darkmass2156/PCS/docs/display/pingu_preview.png

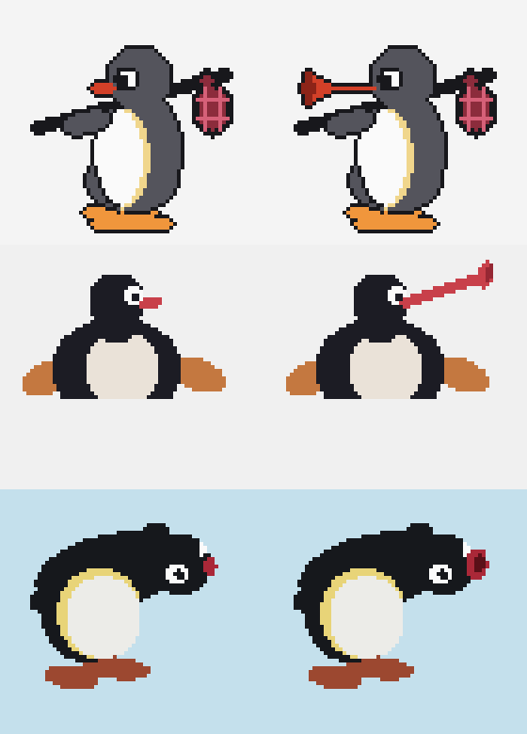
docs/display/pingu_preview.png
