darkmass2156/PCS/docs/display/preview170_boot.png

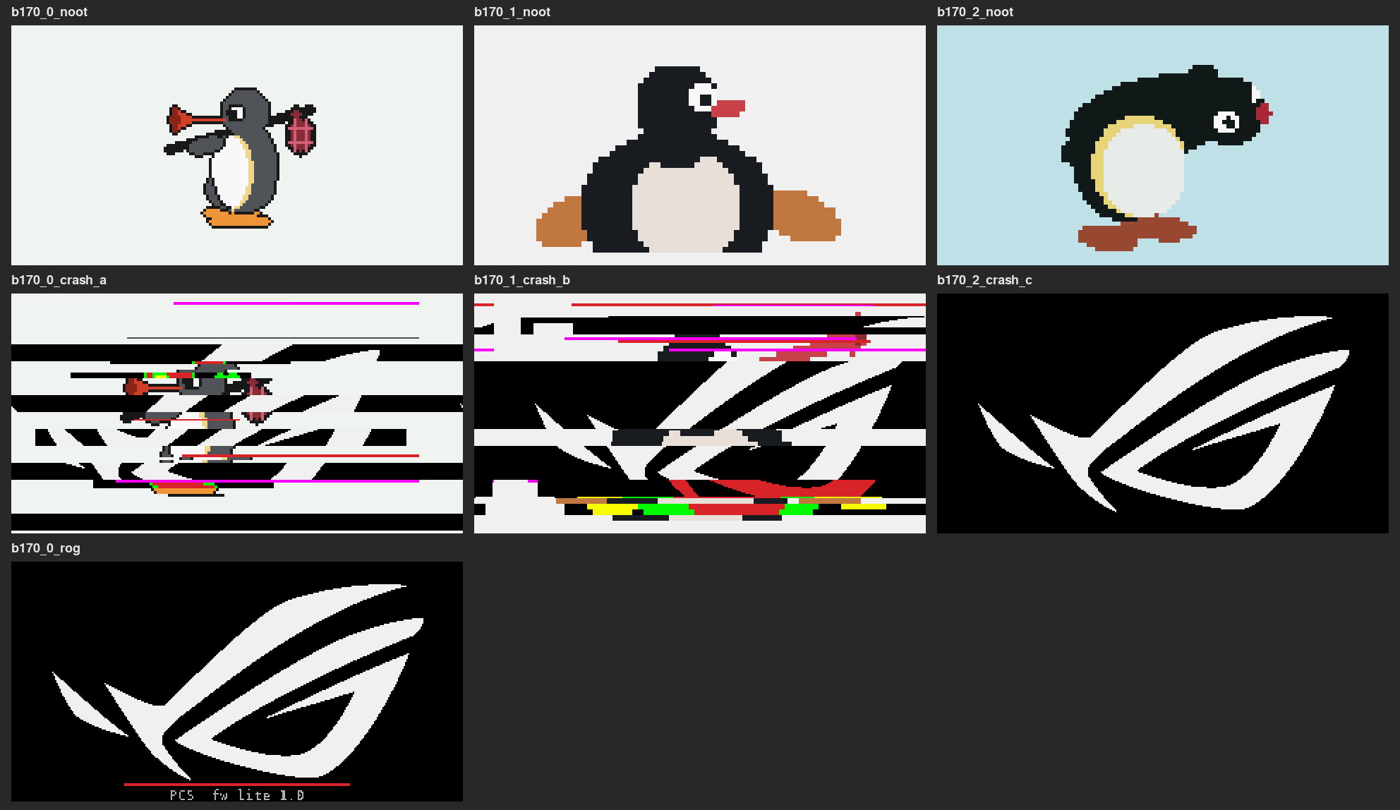
docs/display/preview170_boot.png
