darkmass2156/PCS/docs/display/preview170_modes.png

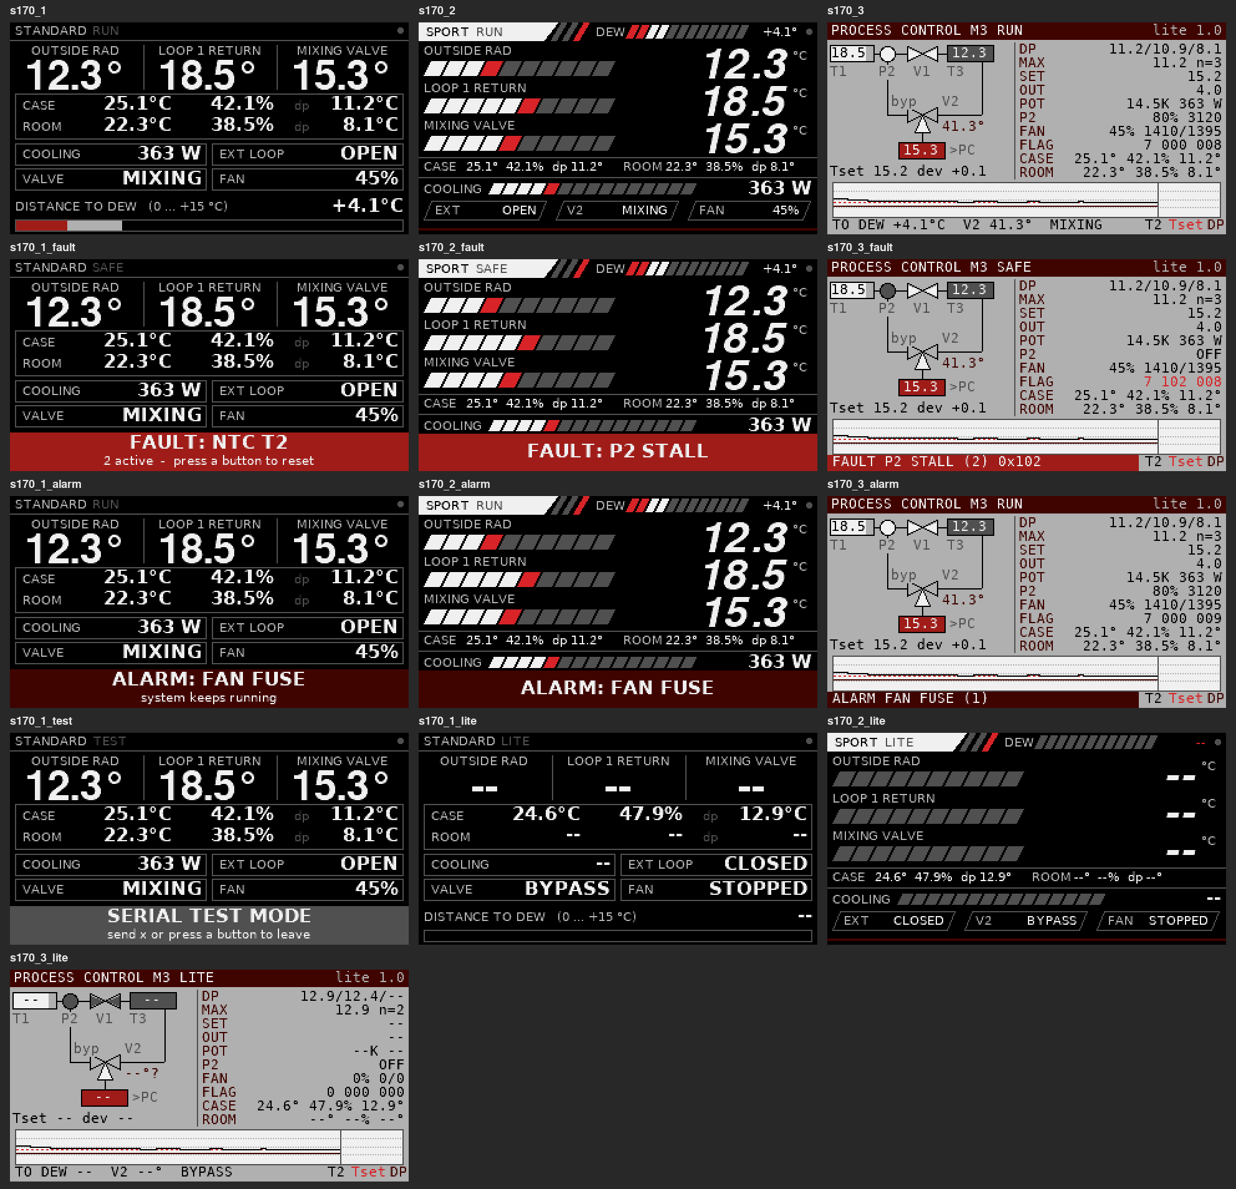
docs/display/preview170_modes.png
