darkmass2156/PCS/docs/display/preview_disp170_log.png

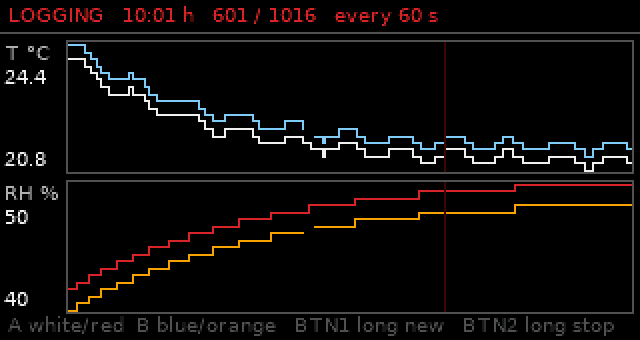
docs/display/preview_disp170_log.png
