darkmass2156/PCS/docs/display/preview_disp170_sht31.png

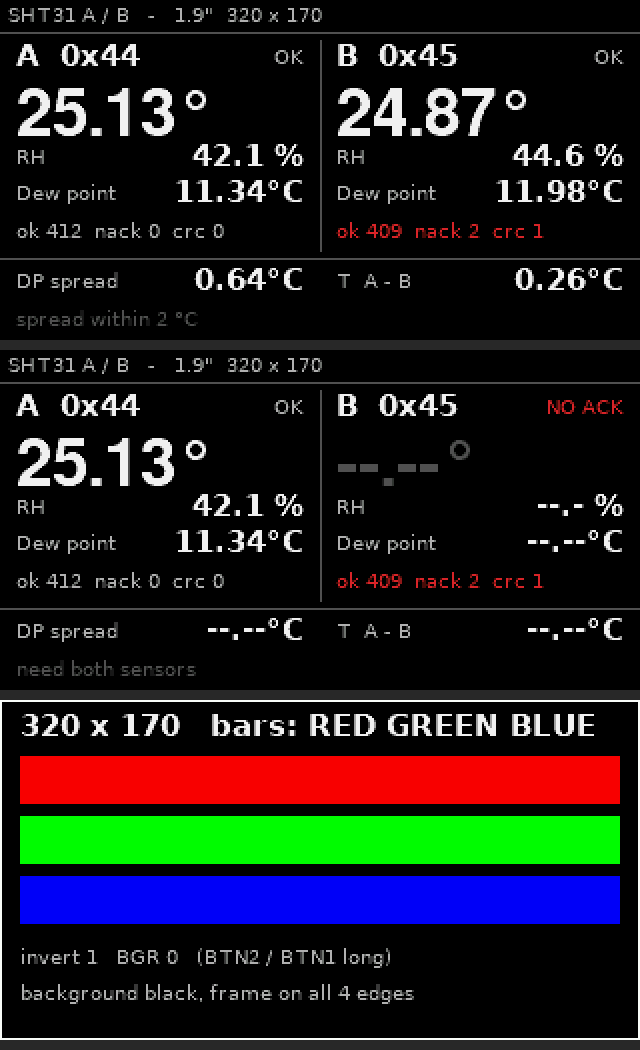
docs/display/preview_disp170_sht31.png
