darkmass2156/PCS/docs/schematics/full_loop_schematic_rev10.png

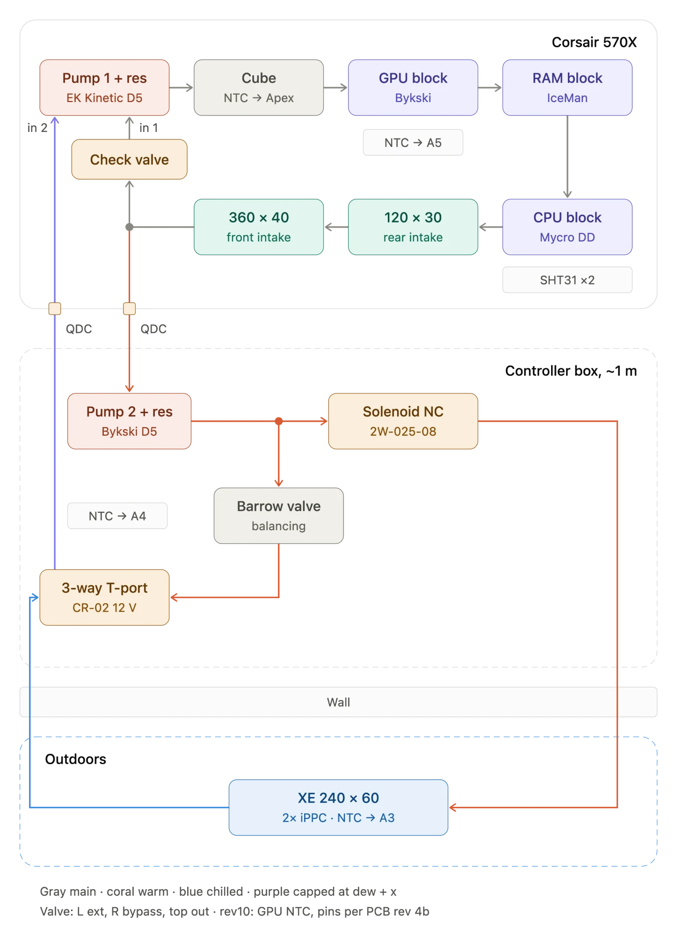
docs/schematics/full_loop_schematic_rev10.png
