darkmass2156/PCS/docs/build_component_list_rev4b.xlsx

Sheet: Summary
Build cost summary
EUR to NOK rate | 11.00 | Input. Mid-market rate, Jul 2026 (latest found via web search). Edit to update all EUR lines.
Category | Subcategory | NOK | Share
Water cooling |  | 11757.13 | 58.8%
 | Pump & reservoir | 1579.52 | 7.9%
 | Radiators | 1655.65 | 8.3%
 | Blocks | 2408.76 | 12.0%
 | Valves & quick disconnects | 1854.47 | 9.3%
 | Fittings | 2618.62 | 13.1%
 | Tubing | 481.73 | 2.4%
 | Coolant | 404.77 | 2.0%
 | Sensors | 262.45 | 1.3%
 | Filling, testing & tools | 491.16 | 2.5%
CPU delid & thermal |  | 3551.78 | 17.8%
 | Delid tools | 1006 | 5.0%
 | Direct-die | 629 | 3.1%
 | Liquid metal | 218 | 1.1%
 | Paste & putty | 705.78 | 3.5%
 | Thermal pads | 598 | 3.0%
 | Protection | 395 | 2.0%
PC build & cabling |  | 1598.35 | 8.0%
 | PSU cable mod | 1092.45 | 5.5%
 | Internal connectivity | 452.01 | 2.3%
 | Mounting | 53.89 | 0.3%
Controller electronics |  | 2649.02 | 13.2%
 | Microcontroller & modules | 418.57 | 2.1%
 | Semiconductors | 190.77 | 1.0%
 | LEDs | 71.56 | 0.4%
 | Passives | 395.28 | 2.0%
 | Fuses & holders | 189.97 | 0.9%
 | Connectors & switches | 564.63 | 2.8%
 | Wire & cable | 549.45 | 2.7%
 | Insulation | 107.42 | 0.5%
 | Prototyping & mounting | 161.37 | 0.8%
Tools & workshop |  | 460.96 | 2.3%
 | Tools | 140.23 | 0.7%
 | Consumables | 139.59 | 0.7%
 | Workspace | 181.14 | 0.9%
Shipping, fees & discounts |  | 1543.945 | 7.7%
 | Shipping | 907.54 | 4.5%
 | Discounts | -168.74 | -0.8%
 | Import MVA (estimate) | 805.145 | 4.0%
Offsets |  | -1650 | -8.2%
 | Sold parts | -1650 | -8.2%
Not project |  | 94.59 | 0.5%
 | Personal | 94.59 | 0.5%
Total, all lines |  | 20005.775
of which being added to Proshop order |  | 485
of which estimates |  | 833.635
of which not project |  | 94.59
Project total (excl. not project) |  | 19911.185
Shop |  | NOK
AliExpress |  | 8389.64
Finn.no (used) |  | 1300
Bykski (Order #EU4231) |  | 4945.41
Alphacool |  | 1813.57
Order #81860 |  | 310.2
Proshop |  | 2219
CS Megastore |  | 776
MDPC-X |  | 1096.81
Import MVA (est.) |  | 805.145
Sold (offset) |  | -1650
Total |  | 20005.775

Sheet: Scope
Scope: in-case loop vs external extension
Scope is set per line in Components, column M (blue = editable). Change it there and this sheet updates.
Scope |  | NOK | Share
In-case loop |  | 11444.1025 | 57.5%
External extension |  | 8467.0825 | 42.5%
Project total |  | 19911.185 | 100.0%
Excludes the Not project line (screen protector).
Scope / category | Subcategory | NOK | Share of scope
In-case loop |  | 11444.1025
Water cooling |  | 6769.98 | 59.2%
 | Pump & reservoir | 929.52 | 8.1%
 | Radiators | 1205.65 | 10.5%
 | Blocks | 2408.76 | 21.0%
 | Valves & quick disconnects | 100.31 | 0.9%
 | Fittings | 1065.33 | 9.3%
 | Tubing | 223.23 | 2.0%
 | Coolant | 267.93 | 2.3%
 | Sensors | 78.09 | 0.7%
 | Filling, testing & tools | 491.16 | 4.3%
CPU delid & thermal |  | 3551.78 | 31.0%
 | Delid tools | 1006 | 8.8%
 | Direct-die | 629 | 5.5%
 | Liquid metal | 218 | 1.9%
 | Paste & putty | 705.78 | 6.2%
 | Thermal pads | 598 | 5.2%
 | Protection | 395 | 3.5%
PC build & cabling |  | 1598.35 | 14.0%
 | PSU cable mod | 1092.45 | 9.5%
 | Internal connectivity | 452.01 | 3.9%
 | Mounting | 53.89 | 0.5%
Tools & workshop |  | 460.96 | 4.0%
 | Tools | 140.23 | 1.2%
 | Consumables | 139.59 | 1.2%
 | Workspace | 181.14 | 1.6%
Shipping, fees & discounts |  | 713.0325 | 6.2%
 | Shipping | 438.83 | 3.8%
 | Import MVA (estimate) | 274.2025 | 2.4%
Offsets |  | -1650 | -14.4%
 | Sold parts | -1650 | -14.4%
External extension |  | 8467.0825
Water cooling |  | 4987.15 | 58.9%
 | Pump & reservoir | 650 | 7.7%
 | Radiators | 450 | 5.3%
 | Valves & quick disconnects | 1754.16 | 20.7%
 | Fittings | 1553.29 | 18.3%
 | Tubing | 258.5 | 3.1%
 | Coolant | 136.84 | 1.6%
 | Sensors | 184.36 | 2.2%
Controller electronics |  | 2649.02 | 31.3%
 | Microcontroller & modules | 418.57 | 4.9%
 | Semiconductors | 190.77 | 2.3%
 | LEDs | 71.56 | 0.8%
 | Passives | 395.28 | 4.7%
 | Fuses & holders | 189.97 | 2.2%
 | Connectors & switches | 564.63 | 6.7%
 | Wire & cable | 549.45 | 6.5%
 | Insulation | 107.42 | 1.3%
 | Prototyping & mounting | 161.37 | 1.9%
Shipping, fees & discounts |  | 830.9125 | 9.8%
 | Shipping | 468.71 | 5.5%
 | Discounts | -168.74 | -2.0%
 | Import MVA (estimate) | 530.9425 | 6.3%

Sheet: PC parts
PC parts: bought vs listing price
Blue = input (prices from Vlad). Bought and listing prices are per unit. Net bought = qty x bought + offset (credits negative, losses positive).
Part | Spec | Qty | Bought / unit | Offset (+ adds / - credits) | Listing / unit | Net bought | Listing total | Saved | Saved % | Note
Intel Core Ultra 7 270K Plus | CPU | 1 | 2999 | -2100 | 3600 | 899 | 3600 | 2701 | 75.02777778% | Offset 2 100 kr from selling the 285K (itself offset by the RAM sale)
ASUS ROG Maximus Z890 Apex | Motherboard | 1 | 2500 | 0 | 5500 | 2500 | 5500 | 3000 | 54.54545455%
G.Skill TZ5CK | DDR5 8400 CUDIMM | 1 | 6783 | 0 | 16800 | 6783 | 16800 | 10017 | 59.625% | Listing = current price
HyperX Fury SSD | PCIe 4.0 | 1 | 2490 | 0 | 4400 | 2490 | 4400 | 1910 | 43.40909091%
Corsair RM1000e | PSU | 1 | 1000 | -1000 | 1900 | 0 | 1900 | 1900 | 100% | Offset 1 000 kr from the same RAM sale as the 270K offset
Noctua NF-A12x25 G2 | 120 mm fan | 4 | 340 | 0 | 340 | 1360 | 1360 | 0 | 0%
Noctua NF-A12x25 G1 | 120 mm fan | 3 | 220 | 0 | 300 | 660 | 900 | 240 | 26.66666667%
ASUS TUF RTX 4070 Ti Super | GPU | 1 | 5700 | 1200 | 9000 | 6900 | 9000 | 2100 | 23.33333333% | Loss on the old 4070 Ti: bought 6 200, sold 5 000
Total |  |  |  | -1900 |  | 21592 | 43460 | 21868 | 50.31753336%
Whole build
Cooling & mod project (Scope sheet) |  |  |  |  |  | 19911.185
PC parts (net bought) |  |  |  |  |  | 21592
Total |  |  |  |  |  | 41503.185
Total value of all parts
Cooling & mod parts (at cost, excl. sold-parts offset) |  |  |  |  |  | 21561.185
PC parts (listing value) |  |  |  |  |  | 43460
Total value of all parts |  |  |  |  |  | 65021.185
Cooling parts have no listing price, so they are valued at what was paid (incl. shipping and import MVA). The 1 650 kr rebate is excluded since it is not a part.

Sheet: Trade history
Trade history: hardware bought, sold and kept
Blue = amounts from Vlad. Yellow = assumption to confirm. Green = current value linked from the PC parts sheet.
Purchases
Deal | What was bought | Price paid
1 | Bundle: 285K, Z890 TUF, 64 GB Kingston Server Premier 4800, RM1000e, be quiet! 802, Cooler Master 360 AIO, Samsung 500 GB SSD | 10500
2 | G.Skill TZ5RK (AliExpress) | 7600
3 | ASUS ROG Maximus Z890 Apex | 2500
4 | ASUS ROG Strix Z890-F | 500
5 | Lightloop 360 AIO | 1550
6 | HyperX Fury 2 TB PCIe 4.0 SSD | 2490
7 | RTX 4070 Ti | 6200
8 | Bundle: ASUS TUF 4070 Ti Super (5 700) + Corsair RM850e (500) | 6200
9 | Bundle: 265KF, Z890 Eagle WiFi 7, 48 GB TZ5CK, Peerless Assassin 140 | 11300
10 | Contact frame | 60
 | Total bought | 48900
Items & outcome
Deal | Item | Outcome | Sold for | Current value (kept) | Note
1 | Intel Core Ultra 9 285K | Sold | 3500
1 | ASUS TUF Z890 | Sold | 1200
1 | Kingston Server Premier 64 GB 4800 | Sold | 7900
1 | Corsair RM1000e | Kept, this rig |  | 1900
1 | be quiet! 802 | Kept, other rig |  |  | Not valued
1 | Cooler Master 360 AIO | Kept, other rig |  |  | Not valued
1 | Samsung 500 GB SSD | Sold in bundle |  |  | See bundle sale line
2 | G.Skill TZ5RK | Sold in bundle |  |  | See bundle sale line
3 | ASUS ROG Maximus Z890 Apex | Kept, this rig |  | 5500
4 | ASUS ROG Strix Z890-F | Sold in bundle |  |  | See bundle sale line
5 | Lightloop 360 AIO | Sold in bundle |  |  | Its 1 500 kr share of the bundle sale is used as part of the 1 650 kr Scope rebate
6 | HyperX Fury 2 TB SSD | Kept, this rig |  | 4400
7 | RTX 4070 Ti | Sold | 5000 |  | Confirmed
8 | ASUS TUF RTX 4070 Ti Super | Kept, this rig |  | 9000
8 | Corsair RM850e | Kept, spare |  |  | Kept as a spare for now; not valued
9 | Intel Core Ultra 7 265KF | Sold in bundle |  |  | See bundle sale line
9 | Gigabyte Z890 Eagle WiFi 7 | Sold | 1350
9 | G.Skill TZ5CK 48 GB | Kept, this rig |  | 16800
9 | Thermalright Peerless Assassin 140 | Sold | 350
10 | Contact frame | Sold | 150 |  | Sold separately; part of the 1 650 kr Scope rebate
- | Bundle sale: 265KF + TZ5RK + Strix Z890-F + Lightloop 360 + Samsung 500 GB | Sold (bundle) | 12490
 | Total |  | 31940 | 37600
Result
 | Total bought | 48900
 | Total sold | 31940
 | Net cash into hardware (bought - sold) | 16960
 | Current value kept in this rig | 37600
 | Value gained on trades (this rig) | 20640
 | Not valued: be quiet! 802 and CM 360 AIO (kept in another rig) and the RM850e (spare). The 270K Plus and Noctua fans were bought outside these trades.

Sheet: Components
# | Category | Subcategory | Part | Spec / variant | Qty | Shop | Price paid | Currency | Price NOK (incl. MVA) | Status | Note | Scope
1 | Water cooling | Pump & reservoir | Bykski B-UL-D5-X-V4 D5 pump + reservoir | 100 mm reservoir | 1 | AliExpress | 929.52 | NOK | 929.52 | Awaiting delivery |  | In-case loop
2 | Water cooling | Pump & reservoir | EKWB D5 pump + reservoir | Used | 1 | Finn.no (used) | 650.00 | NOK | 650.00 | Bought (used) | 1 300 kr Finn bundle, split by estimated used value | External extension
3 | Water cooling | Radiators | Bykski 360 mm radiator D40 V2 | Full copper | 1 | Bykski (Order #EU4231) | 1005.65 | NOK | 1005.65 | Ordered | Ex-MVA price + 25% MVA | In-case loop
4 | Water cooling | Radiators | EK XE 240 radiator | 60 mm, used (outdoor) | 1 | Finn.no (used) | 450.00 | NOK | 450.00 | Bought (used) | 1 300 kr Finn bundle, split by estimated used value | External extension
5 | Water cooling | Radiators | 120 mm radiator | 30 mm, used (rear) | 1 | Finn.no (used) | 200.00 | NOK | 200.00 | Bought (used) | 1 300 kr Finn bundle, split by estimated used value | In-case loop
6 | Water cooling | Blocks | GPU water block ASUS TUF 4070 Ti | Incl. backplate | 1 | Bykski (Order #EU4231) | 1676.19 | NOK | 1676.19 | Ordered | Ex-MVA price + 25% MVA (rounded to match order total) | In-case loop
7 | Water cooling | Blocks | IceManCooler dual-channel memory water block | Black | 1 | AliExpress | 506.25 | NOK | 506.25 | Awaiting delivery |  | In-case loop
8 | Water cooling | Blocks | Bykski DDR5 RAM heatsink (water cooling) | 2 pcs | 1 | AliExpress | 226.32 | NOK | 226.32 | Awaiting delivery |  | In-case loop
9 | Water cooling | Valves & quick disconnects | Motorized ball valve CR02 | 3-way, 12 V DC, DN15 | 1 | AliExpress | 586.92 | NOK | 586.92 | Processing |  | External extension
10 | Water cooling | Valves & quick disconnects | AICANTEC solenoid valve | 12 V DC, 1/2" | 1 | AliExpress | 303.19 | NOK | 303.19 | Awaiting delivery |  | External extension
11 | Water cooling | Valves & quick disconnects | AICANTEC solenoid valve | 12 V DC, 1/4" | 1 | AliExpress | 18.11 | EUR | 199.21 | Awaiting delivery |  | External extension
12 | Water cooling | Valves & quick disconnects | Bykski hand-tighten drain valve G1/4 | Black | 1 | AliExpress | 100.31 | NOK | 100.31 | Processing |  | In-case loop
13 | Water cooling | Valves & quick disconnects | Alphacool Eiszapfen quick-release coupling G1/4 AG | Deep Black | 2 | Alphacool | 31.90 | EUR | 350.90 | Ordered |  | External extension
14 | Water cooling | Valves & quick disconnects | Alphacool Eiszapfen quick-release connector G1/4 IG | Deep Black | 2 | Alphacool | 28.54 | EUR | 313.94 | Ordered |  | External extension
15 | Water cooling | Fittings | Barrow THKN-3/8-B03 compression fitting | 10/13 mm, black | 2 | AliExpress | 89.33 | NOK | 89.33 | Processing |  | External extension
16 | Water cooling | Fittings | Barrow soft-tube compression fittings | ID10/OD13, black, 12-pack | 1 | AliExpress | 278.79 | NOK | 278.79 | Awaiting delivery |  | External extension
17 | Water cooling | Fittings | 10x13 Flex Fitting V2 | Black | 16 | Bykski (Order #EU4231) | 803.60 | NOK | 803.60 | Ordered | Ex-MVA price + 25% MVA | In-case loop
18 | Water cooling | Fittings | Alphacool HF 13/10 screw-on barb G1/4 | Deep Black | 8 | Alphacool | 25.44 | EUR | 279.84 | Ordered |  | External extension
19 | Water cooling | Fittings | Bykski 3-way cubic splitter G1/4 | Black | 2 | AliExpress | 172.26 | NOK | 172.26 | Processing |  | External extension
20 | Water cooling | Fittings | Freezemod Y-splitter | Black | 1 | AliExpress | 34.98 | NOK | 34.98 | Processing |  | External extension
21 | Water cooling | Fittings | Cube adapter 3-way | Black | 1 | Bykski (Order #EU4231) | 61.40 | NOK | 61.40 | Ordered | Ex-MVA price + 25% MVA | In-case loop
22 | Water cooling | Fittings | Alphacool HF 5-way distributor G1/4 IG | Deep Black | 1 | Alphacool | 5.36 | EUR | 58.96 | Ordered |  | External extension
23 | Water cooling | Fittings | Alphacool Eiszapfen L-connector rotatable G1/4 | Deep Black, 4-pack | 1 | Alphacool | 19.31 | EUR | 212.41 | Ordered |  | External extension
24 | Water cooling | Fittings | Bykski extension fitting F-M | Black, 7.5 mm | 2 | AliExpress | 82.76 | NOK | 82.76 | Processing |  | External extension
25 | Water cooling | Fittings | Extension M/F | Black, 7.5 mm | 1 | Bykski (Order #EU4231) | 33.39 | NOK | 33.39 | Ordered | Ex-MVA price + 25% MVA | In-case loop
26 | Water cooling | Fittings | Bykski B-DTJ-MI mini double male | Black | 2 | AliExpress | 67.97 | NOK | 67.97 | Processing |  | External extension
27 | Water cooling | Fittings | Brass hex bushing | F1/4 to M1/2 | 2 | AliExpress | 63.58 | NOK | 63.58 | Awaiting delivery |  | External extension
28 | Water cooling | Fittings | G1/4 knurled stop plug | White | 5 | Bykski (Order #EU4231) | 166.94 | NOK | 166.94 | Ordered | Ex-MVA price + 25% MVA | In-case loop
29 | Water cooling | Fittings | Alphacool HF slot panel "Panama" | PCI slot pass-through | 1 | Alphacool | 19.31 | EUR | 212.41 | Ordered |  | External extension
30 | Water cooling | Tubing | Bykski 10x13 PVC tube | Clear, 3 m | 2 | Bykski (Order #EU4231) | 223.23 | NOK | 223.23 | Ordered | Ex-MVA price + 25% MVA | In-case loop
31 | Water cooling | Tubing | Alphacool EPDM tube 13/10 | Black, 3.3 m | 2 | Alphacool | 23.50 | EUR | 258.50 | Ordered |  | External extension
32 | Water cooling | Coolant | Double Protect Ultra 1 L | Clear | 2 | Bykski (Order #EU4231) | 267.93 | NOK | 267.93 | Ordered | Ex-MVA price + 25% MVA | In-case loop
33 | Water cooling | Coolant | Ethylene glycol pure 500 ml (WARCHEM) |  | 2 | Order #81860 | 12.44 | EUR | 136.84 | Ordered | No MVA charged | External extension
34 | Water cooling | Sensors | Bykski B-PD5-TMR temperature probe | Silver | 3 | AliExpress | 16.76 | EUR | 184.36 | Awaiting delivery |  | External extension
35 | Water cooling | Sensors | Bykski temperature sensor plug G1/4 | Black | 1 | Bykski (Order #EU4231) | 78.09 | NOK | 78.09 | Ordered | Ex-MVA price + 25% MVA | In-case loop
36 | Water cooling | Filling, testing & tools | Bykski Leak Tester V5 (B-DTH-K40-V5) |  | 1 | Bykski (Order #EU4231) | 335.12 | NOK | 335.12 | Ordered | Ex-MVA price + 25% MVA | In-case loop
37 | Water cooling | Filling, testing & tools | Fill bottle 250 ml |  | 1 | Bykski (Order #EU4231) | 55.74 | NOK | 55.74 | Ordered | Ex-MVA price + 25% MVA | In-case loop
38 | Water cooling | Filling, testing & tools | 24-pin ATX bridging plug |  | 1 | Bykski (Order #EU4231) | 33.39 | NOK | 33.39 | Ordered | Ex-MVA price + 25% MVA | In-case loop
39 | Water cooling | Filling, testing & tools | Hose cutter |  | 1 | Bykski (Order #EU4231) | 66.91 | NOK | 66.91 | Ordered | Ex-MVA price + 25% MVA | In-case loop
40 | CPU delid & thermal | Delid tools | Thermal Grizzly Delid-Die-Mate V1 (1851) |  | 1 | Proshop | 289.00 | NOK | 289.00 | Ordered | Used with the Heater (melts indium on 270K Plus) | In-case loop
41 | CPU delid & thermal | Delid tools | Thermal Grizzly Delid-Die-Mate Heater V1 (1851) | TG-DDMH-i1851-V1 | 1 | CS Megastore | 717.00 | NOK | 717.00 | Ordered | Ex-MVA price + 25% MVA | In-case loop
42 | CPU delid & thermal | Direct-die | Thermal Grizzly Mycro Direct-Die Pro RG (1851) |  | 1 | Proshop | 629.00 | NOK | 629.00 | Ordered |  | In-case loop
43 | CPU delid & thermal | Liquid metal | Thermal Grizzly Conductonaut Extreme |  | 1 | Proshop | 179.00 | NOK | 179.00 | Ordered |  | In-case loop
44 | CPU delid & thermal | Liquid metal | Thermal Grizzly liquid metal applicator | 3 pcs | 1 | Proshop | 39.00 | NOK | 39.00 | Ordered |  | In-case loop
45 | CPU delid & thermal | Paste & putty | Halnziye HY-P17 thermal paste | 4 g | 2 | AliExpress | 346.78 | NOK | 346.78 | Awaiting delivery | Incl. ~100 kr shipping | In-case loop
46 | CPU delid & thermal | Paste & putty | Thermal Grizzly Putty Pro | 30 g | 1 | Proshop | 359.00 | NOK | 359.00 | Adding to order | Being added to the open Proshop order (no extra shipping) | In-case loop
47 | CPU delid & thermal | Thermal pads | Thermal Grizzly Minus Pad Pro | 120x20x0.5 mm, 2 pcs | 1 | Proshop | 151.00 | NOK | 151.00 | Ordered |  | In-case loop
48 | CPU delid & thermal | Thermal pads | Thermal Grizzly Minus Pad Advance | 100x100x2.0 mm | 1 | Proshop | 189.00 | NOK | 189.00 | Ordered |  | In-case loop
49 | CPU delid & thermal | Thermal pads | Thermal Grizzly Minus Pad HC | 120x100x1 mm, 2 pcs | 1 | Proshop | 129.00 | NOK | 129.00 | Ordered |  | In-case loop
50 | CPU delid & thermal | Thermal pads | Thermal Grizzly Minus Pad HC | 120x100x2 mm, 2 pcs | 1 | Proshop | 129.00 | NOK | 129.00 | Ordered |  | In-case loop
51 | CPU delid & thermal | Protection | Thermal Grizzly GPU Guard | NVIDIA 4090/5090/5080 | 1 | Proshop | 126.00 | NOK | 126.00 | Adding to order | Fits AD103 (same die size as GB203); being added to the open Proshop order | In-case loop
52 | CPU delid & thermal | Protection | LGA-17xx/18xx CPU socket cover | Black, 10 pcs | 1 | AliExpress | 120.46 | NOK | 120.46 | Awaiting delivery |  | In-case loop
53 | CPU delid & thermal | Protection | CPU inner support blister (Intel) | 10 pcs | 2 | AliExpress | 48.07 | NOK | 48.07 | Awaiting delivery |  | In-case loop
54 | CPU delid & thermal | Protection | Kapton high-temp tape | 33 m, 5 mm | 1 | AliExpress | 24.93 | NOK | 24.93 | Awaiting delivery | Share of multi-item order total | In-case loop
55 | CPU delid & thermal | Protection | Kapton high-temp tape | 33 m, 10 mm | 1 | AliExpress | 33.86 | NOK | 33.86 | Awaiting delivery | Share of multi-item order total | In-case loop
56 | CPU delid & thermal | Protection | Kapton high-temp tape | 33 m, 15 mm | 1 | AliExpress | 41.68 | NOK | 41.68 | Awaiting delivery | Share of multi-item order total | In-case loop
57 | PC build & cabling | PSU cable mod | MDPC-X 17 AWG hook-up wire | C-White | 40 | MDPC-X | 28.80 | EUR | 316.80 | Ordered | No MVA charged; qty as invoiced | In-case loop
58 | PC build & cabling | PSU cable mod | MDPC-X sleeving MICRO | Haze-Grey | 30 | MDPC-X | 19.50 | EUR | 214.50 | Ordered | No MVA charged; qty as invoiced | In-case loop
59 | PC build & cabling | PSU cable mod | MDPC-X sleeving MICRO | Vanilla-Sands | 10 | MDPC-X | 7.20 | EUR | 79.20 | Ordered | No MVA charged; qty as invoiced | In-case loop
60 | PC build & cabling | PSU cable mod | MDPC-X connector 24-pin ATX |  | 1 | MDPC-X | 1.45 | EUR | 15.95 | Ordered | No MVA charged | In-case loop
61 | PC build & cabling | PSU cable mod | MDPC-X connector 18-pin ATX |  | 1 | MDPC-X | 1.33 | EUR | 14.63 | Ordered | No MVA charged | In-case loop
62 | PC build & cabling | PSU cable mod | MDPC-X connector 10-pin ATX |  | 1 | MDPC-X | 1.10 | EUR | 12.10 | Ordered | No MVA charged | In-case loop
63 | PC build & cabling | PSU cable mod | MDPC-X connector 8-pin ATX/EPS |  | 5 | MDPC-X | 4.80 | EUR | 52.80 | Ordered | No MVA charged | In-case loop
64 | PC build & cabling | PSU cable mod | MDPC-X connector 6-pin ATX |  | 1 | MDPC-X | 0.96 | EUR | 10.56 | Ordered | No MVA charged | In-case loop
65 | PC build & cabling | PSU cable mod | MDPC-X 8-pin PCI-E connector (Molex) |  | 1 | MDPC-X | 1.32 | EUR | 14.52 | Ordered | No MVA charged | In-case loop
66 | PC build & cabling | PSU cable mod | MDPC-X crimp terminal ATX female |  | 3 | MDPC-X | 11.25 | EUR | 123.75 | Ordered | No MVA charged; qty as invoiced | In-case loop
67 | PC build & cabling | PSU cable mod | PET braided cable sleeve | Grey, 12 mm, 5 m | 1 | AliExpress | 47.19 | NOK | 47.19 | Processing | Share of multi-item order total | In-case loop
68 | PC build & cabling | PSU cable mod | PET braided cable sleeve | White, 12 mm, 5 m | 1 | AliExpress | 47.38 | NOK | 47.38 | Processing | Share of multi-item order total | In-case loop
69 | PC build & cabling | PSU cable mod | PET braided cable sleeve | White, 4 mm, 5 m | 1 | AliExpress | 31.26 | NOK | 31.26 | Processing | Share of multi-item order total | In-case loop
70 | PC build & cabling | PSU cable mod | PET braided cable sleeve | White, 2 mm, 5 m | 1 | AliExpress | 29.49 | NOK | 29.49 | Processing | Share of multi-item order total | In-case loop
71 | PC build & cabling | PSU cable mod | PSU modding pin removal tool |  | 1 | AliExpress | 42.62 | NOK | 42.62 | Awaiting delivery |  | In-case loop
72 | PC build & cabling | PSU cable mod | Cable comb tool set | White | 1 | AliExpress | 39.70 | NOK | 39.70 | Awaiting delivery |  | In-case loop
73 | PC build & cabling | Internal connectivity | USB 3.2 Gen2x2 20 Gbps front panel cable | 50 cm, black | 2 | AliExpress | 219.65 | NOK | 219.65 | Processing |  | In-case loop
74 | PC build & cabling | Internal connectivity | SATA 15-pin M-F extension | 32 cm | 2 | AliExpress | 5.10 | EUR | 56.10 | Awaiting delivery |  | In-case loop
75 | PC build & cabling | Internal connectivity | SATA to 4-pin fan splitter | 1-to-1 | 1 | AliExpress | 2.59 | EUR | 28.49 | Estimate | Order total not visible: unit price + 25% | In-case loop
76 | PC build & cabling | Internal connectivity | Okvyuan 5 V 3-pin ARGB hub | SATA powered | 1 | AliExpress | 67.67 | NOK | 67.67 | Processing |  | In-case loop
77 | PC build & cabling | Internal connectivity | Neon 5 V 3-pin ARGB strip | 1 pc, no plug | 1 | AliExpress | 80.10 | NOK | 80.10 | Processing |  | In-case loop
78 | PC build & cabling | Mounting | Hook & loop (velcro) tape | Black, 20 mm, 5 m | 1 | AliExpress | 53.89 | NOK | 53.89 | Awaiting delivery |  | In-case loop
79 | Controller electronics | Microcontroller & modules | MEGA2560 R3 (CH340) | Incl. Type-C cable | 1 | AliExpress | 17.61 | EUR | 193.71 | Awaiting delivery | Share of multi-item order total | External extension
80 | Controller electronics | Microcontroller & modules | Relay module 2-channel | 24 V | 1 | AliExpress | 2.39 | EUR | 26.29 | Awaiting delivery | Share of multi-item order total | External extension
81 | Controller electronics | Microcontroller & modules | Relay module 2-channel | 12 V | 1 | AliExpress | 27.21 | NOK | 27.21 | Processing |  | External extension
82 | Controller electronics | Microcontroller & modules | SHT31 temperature/humidity module | 1 pc | 2 | AliExpress | 65.87 | NOK | 65.87 | Processing |  | External extension
83 | Controller electronics | Microcontroller & modules | SHT30 temperature/humidity module | 1 pc | 3 | AliExpress | 6.15 | EUR | 67.65 | Awaiting delivery |  | External extension
84 | Controller electronics | Semiconductors | IRLB8721 MOSFET TO-220 | 20 pcs | 1 | AliExpress | 56.37 | NOK | 56.37 | Awaiting delivery |  | External extension
85 | Controller electronics | Semiconductors | IRF4905 MOSFET | 10 pcs | 1 | AliExpress | 45.90 | NOK | 45.90 | Processing |  | External extension
86 | Controller electronics | Semiconductors | BC547/BC557 transistors | 50 pcs (25 each) | 1 | AliExpress | 16.18 | NOK | 16.18 | Processing |  | External extension
87 | Controller electronics | Semiconductors | SB560 Schottky diode | 10 pcs | 1 | AliExpress | 23.92 | NOK | 23.92 | Awaiting delivery |  | External extension
88 | Controller electronics | Semiconductors | 1N5819 Schottky diode | 100 pcs | 1 | AliExpress | 4.40 | EUR | 48.40 | Awaiting delivery |  | External extension
89 | Controller electronics | LEDs | RGB LED 5 mm diffused | Common cathode, 36 pcs | 1 | AliExpress | 23.95 | NOK | 23.95 | Processing |  | External extension
90 | Controller electronics | LEDs | RGB LED 5 mm diffused | Common anode, 15 pcs | 1 | AliExpress | 22.74 | NOK | 22.74 | Processing |  | External extension
91 | Controller electronics | LEDs | LED kit 3/5 mm round | 5 mm box | 1 | AliExpress | 24.87 | NOK | 24.87 | Awaiting delivery |  | External extension
92 | Controller electronics | Passives | 1 W 1% metal film resistor | 220 ohm, 50 pcs | 1 | AliExpress | 46.66 | NOK | 46.66 | Awaiting delivery |  | External extension
93 | Controller electronics | Passives | 1 W 1% metal film resistor | 330 ohm, 50 pcs | 1 | AliExpress | 46.56 | NOK | 46.56 | Awaiting delivery |  | External extension
94 | Controller electronics | Passives | 1/4 W metal film resistor | 10 kohm, 100 pcs | 1 | AliExpress | 1.84 | EUR | 20.24 | Awaiting delivery |  | External extension
95 | Controller electronics | Passives | 1/4 W metal film resistor | 4.7 kohm, 100 pcs | 1 | AliExpress | 1.82 | EUR | 20.02 | Awaiting delivery | Share of multi-item order total | External extension
96 | Controller electronics | Passives | 1/4 W metal film resistor | 220 kohm, 100 pcs | 1 | AliExpress | 1.84 | EUR | 20.24 | Awaiting delivery | Share of multi-item order total | External extension
97 | Controller electronics | Passives | 3296W trimmer potentiometer | 10 kohm, 10 pcs | 1 | AliExpress | 23.35 | NOK | 23.35 | Processing |  | External extension
98 | Controller electronics | Passives | Ceramic capacitor 50 V (YXYchip) | 100 nF, 100 pcs | 1 | AliExpress | 21.28 | NOK | 21.28 | Awaiting delivery |  | External extension
99 | Controller electronics | Passives | Ceramic capacitor 50 V (VENTENY) | 100 nF, 100 pcs | 1 | AliExpress | 2.18 | EUR | 23.98 | Awaiting delivery |  | External extension
100 | Controller electronics | Passives | Electrolytic capacitor | 470 uF 25 V 8x12, 20 pcs | 1 | AliExpress | 19.80 | NOK | 19.80 | Awaiting delivery |  | External extension
101 | Controller electronics | Passives | Electrolytic capacitor NHG | 10 uF 16 V 4x5, 30 pcs | 1 | AliExpress | 18.46 | NOK | 18.46 | Processing |  | External extension
102 | Controller electronics | Passives | Ferrite ring core | 3.5 mm, black, 10 pcs | 1 | AliExpress | 76.14 | NOK | 76.14 | Awaiting delivery |  | External extension
103 | Controller electronics | Fuses & holders | Glass fuse 5x20 slow blow | 1 A, 5 pcs | 1 | AliExpress | 21.20 | NOK | 21.20 | Awaiting delivery |  | External extension
104 | Controller electronics | Fuses & holders | Glass fuse 5x20 slow blow | 3.15 A, 5 pcs | 1 | AliExpress | 21.42 | NOK | 21.42 | Awaiting delivery | Share of multi-item order total | External extension
105 | Controller electronics | Fuses & holders | Glass fuse 5x20 slow blow | 4 A, 5 pcs | 1 | AliExpress | 21.42 | NOK | 21.42 | Awaiting delivery | Share of multi-item order total | External extension
106 | Controller electronics | Fuses & holders | Glass fuse 5x20 slow blow | 6.3 A, 5 pcs | 1 | AliExpress | 21.16 | NOK | 21.16 | Awaiting delivery | Share of multi-item order total | External extension
107 | Controller electronics | Fuses & holders | Panel-mount PCB fuse holder 5x20 | 10 pcs | 2 | AliExpress | 43.28 | NOK | 43.28 | Awaiting delivery |  | External extension
108 | Controller electronics | Fuses & holders | Waterproof inline mini blade fuse holder | 18 AWG, 5 A, 1 pair | 1 | AliExpress | 5.59 | EUR | 61.49 | Awaiting delivery |  | External extension
109 | Controller electronics | Connectors & switches | GX12 aviation plug male + female | 2P | 2 | AliExpress | 4.98 | EUR | 54.78 | Awaiting delivery | Share of multi-item order total | External extension
110 | Controller electronics | Connectors & switches | GX12 aviation plug male + female | 3P | 2 | AliExpress | 4.98 | EUR | 54.78 | Awaiting delivery | Share of multi-item order total | External extension
111 | Controller electronics | Connectors & switches | GX12 aviation plug male + female | 4P | 2 | AliExpress | 5.33 | EUR | 58.63 | Awaiting delivery | Share of multi-item order total | External extension
112 | Controller electronics | Connectors & switches | GX12 aviation plug male + female | 5P | 2 | AliExpress | 5.33 | EUR | 58.63 | Awaiting delivery | Share of multi-item order total | External extension
113 | Controller electronics | Connectors & switches | GX12 aviation plug male + female | 6P | 2 | AliExpress | 5.31 | EUR | 58.41 | Awaiting delivery | Share of multi-item order total | External extension
114 | Controller electronics | Connectors & switches | KF2510 (2540) housing M+F | 4P, 10 sets | 1 | AliExpress | 36.55 | NOK | 36.55 | Awaiting delivery |  | External extension
115 | Controller electronics | Connectors & switches | KF128 2.54 mm PCB screw terminal | 4P, 5 pcs | 1 | AliExpress | 2.20 | EUR | 24.20 | Awaiting delivery |  | External extension
116 | Controller electronics | Connectors & switches | 2.54 mm single-row pin header | Black, 10 pcs | 1 | AliExpress | 18.06 | NOK | 18.06 | Processing |  | External extension
117 | Controller electronics | Connectors & switches | 2.54 mm jumper caps (long) | Black, 100 pcs | 1 | AliExpress | 18.76 | NOK | 18.76 | Processing |  | External extension
118 | Controller electronics | Connectors & switches | Dupont crimp pins | Male, 200 pcs | 1 | AliExpress | 26.55 | NOK | 26.55 | Processing | Share of multi-item order total | External extension
119 | Controller electronics | Connectors & switches | Dupont crimp pins | Female, 200 pcs | 1 | AliExpress | 23.36 | NOK | 23.36 | Processing | Share of multi-item order total | External extension
120 | Controller electronics | Connectors & switches | Dupont housings | 1-pin, 500 pcs | 1 | AliExpress | 29.23 | NOK | 29.23 | Processing | Share of multi-item order total | External extension
121 | Controller electronics | Connectors & switches | Dupont housings | 2-pin, 200 pcs | 1 | AliExpress | 21.66 | NOK | 21.66 | Processing | Share of multi-item order total | External extension
122 | Controller electronics | Connectors & switches | Dupont jumper wires | 30 cm, 1 set | 1 | AliExpress | 5.65 | EUR | 62.15 | Awaiting delivery |  | External extension
123 | Controller electronics | Connectors & switches | SS12F15 slide switch | 10 pcs | 1 | AliExpress | 18.88 | NOK | 18.88 | Awaiting delivery |  | External extension
124 | Controller electronics | Wire & cable | RVV cable 2-core | 18 AWG 0.75 mm2, 2 m | 1 | AliExpress | 5.21 | EUR | 57.31 | Awaiting delivery | Share of multi-item order total | External extension
125 | Controller electronics | Wire & cable | RVSP shielded twisted pair 2-core | 22 AWG 0.3 mm2, black, 10 m | 1 | AliExpress | 14.97 | EUR | 164.67 | Awaiting delivery | Share of multi-item order total | External extension
126 | Controller electronics | Wire & cable | UL2464 sheathed cable 2-core | 20 AWG, black, 10 m | 1 | AliExpress | 12.01 | EUR | 132.11 | Awaiting delivery | Share of multi-item order total | External extension
127 | Controller electronics | Wire & cable | UL2464 sheathed cable 6-core | 24 AWG, black, 10 m | 1 | AliExpress | 17.76 | EUR | 195.36 | Awaiting delivery | Share of multi-item order total | External extension
128 | Controller electronics | Insulation | Heat shrink 3:1 with glue | White, 3.2 mm, 3 m | 1 | AliExpress | 29.98 | NOK | 29.98 | Processing |  | External extension
129 | Controller electronics | Insulation | Heat shrink 3:1 dual-wall | Black, 3.2 mm, 2 m | 1 | AliExpress | 3.01 | EUR | 33.11 | Awaiting delivery | Share of multi-item order total | External extension
130 | Controller electronics | Insulation | Heat shrink 3:1 dual-wall | Black, 7.9 mm, 2 m | 1 | AliExpress | 4.03 | EUR | 44.33 | Awaiting delivery | Share of multi-item order total | External extension
131 | Controller electronics | Prototyping & mounting | Double-sided prototype PCB | 5x7 cm, 5 pcs | 1 | AliExpress | 4.55 | EUR | 50.05 | Awaiting delivery |  | External extension
132 | Controller electronics | Prototyping & mounting | Nylon M3 standoff/screw kit | 650 pcs | 1 | AliExpress | 10.12 | EUR | 111.32 | Awaiting delivery |  | External extension
133 | Controller electronics | Microcontroller & modules | ST7789 IPS display 1.69" (MSP1691) | 240x280, 4-wire SPI, 3.3 V | 1 | AliExpress |  | NOK | 0.00 | Ordered | Ordered both sizes, one gets used; Price not logged yet | External extension
134 | Controller electronics | Microcontroller & modules | ST7789 IPS display 1.9" (MSP1901) | 170x320, 4-wire SPI, 3.3 V | 1 | AliExpress |  | NOK | 0.00 | Ordered | Ordered both sizes, one gets used; Price not logged yet | External extension
135 | Controller electronics | Microcontroller & modules | 0.91" I2C OLED display module | Blue, 128x32 | 2 | AliExpress | 37.84 | NOK | 37.84 | Ordered | UMLIFE Store; 2 x 18.92 kr; not used in rev 4b (ST7789 instead) | External extension
136 | Controller electronics | Passives | Metal film resistor kit 1/4 W ±1% | 30 values, 600 pcs | 1 | AliExpress | 39.63 | NOK | 39.63 | Ordered | UMLIFE Store; covers 47k, 20k, 2k, 1k, 100k, 150 and 100 ohm for rev 4b | External extension
137 | Controller electronics | Passives | Electrolytic capacitor | 100 uF 16 V, 40 pcs | 1 | AliExpress | 18.92 | NOK | 18.92 | Ordered | LXQY Store; Board 2 5 V bulk cap | External extension
138 | Controller electronics | Connectors & switches | 4-pin PWM fan header (motherboard style) | 2.54 mm, 20 pcs | 1 |  |  | NOK | 0.00 | Bought | Price not logged yet | External extension
139 | Controller electronics | Connectors & switches | Right-angle shrouded IDC box header | 34-pin (2x17), 2.54 mm, pack of 10 | 1 |  |  | NOK | 0.00 | To order | Rev 4b uses 3: Board 1 ribbon, Board 2 ribbon, Board 2 Mega ribbon | External extension
140 | Controller electronics | Connectors & switches | IDC female socket FC-34P | 34-pin, for 1.27 mm ribbon | 3 |  |  | NOK | 0.00 | To order | 2 for Board 1-2 ribbon, 1 for the Mega ribbon | External extension
141 | Controller electronics | Connectors & switches | Dupont multi-pin housings | 1x6 x2, 1x4 x3, 2x2 x1 | 6 |  |  | NOK | 0.00 | To order | Optional: Mega-end groups; can gang 1-pin/2-pin housings instead | External extension
142 | Controller electronics | Wire & cable | Flat ribbon cable 28 AWG | 1.27 mm pitch | 1 |  |  | NOK | 0.00 | Bought | Already on hand; Price not logged yet | External extension
143 | Controller electronics | Prototyping & mounting | Double-sided prototype PCB | 6x8 cm (22x27 holes), 10 pcs | 1 | Kjell & Company |  | NOK | 0.00 | Bought | Rev 4b uses 2 (power + logic); Price not logged yet | External extension
144 | Tools & workshop | Tools | YE-12MB crimping tool |  | 1 | AliExpress | 140.23 | NOK | 140.23 | Awaiting delivery |  | In-case loop
145 | Tools & workshop | Consumables | Leaded solder 63/37 rosin core | 1.0 mm, 100 g | 1 | AliExpress | 12.69 | EUR | 139.59 | Awaiting delivery |  | In-case loop
146 | Tools & workshop | Workspace | Antistatic ESD silicone soldering mat | S-160, 45x30 cm | 1 | AliExpress | 181.14 | NOK | 181.14 | Awaiting delivery |  | In-case loop
147 | Shipping, fees & discounts | Shipping | Shipping, Bykski (Order #EU4231) |  | 1 | Bykski (Order #EU4231) | 137.83 | NOK | 137.83 | Ordered | Ex-MVA price + 25% MVA | In-case loop
148 | Shipping, fees & discounts | Shipping | Shipping, Alphacool (DHL Premium) |  | 1 | Alphacool | 26.85 | EUR | 295.35 | Ordered |  | External extension
149 | Shipping, fees & discounts | Shipping | Shipping, MDPC-X (DHL) |  | 1 | MDPC-X | 22.00 | EUR | 242.00 | Ordered |  | In-case loop
150 | Shipping, fees & discounts | Shipping | Shipping, CS Megastore (Instabox) |  | 1 | CS Megastore | 59.00 | NOK | 59.00 | Ordered | Ex-MVA price + 25% MVA | In-case loop
151 | Shipping, fees & discounts | Shipping | Shipping, Order #81860 |  | 1 | Order #81860 | 15.76 | EUR | 173.36 | Ordered |  | External extension
152 | Shipping, fees & discounts | Discounts | Alphacool 10% voucher |  | 1 | Alphacool | -15.34 | EUR | -168.74 | Ordered |  | External extension
153 | Shipping, fees & discounts | Import MVA (estimate) | Import MVA, MDPC-X order | 25% of MDPC-X total | 1 | Import MVA (est.) | 24.93 | EUR | 274.20 | Estimate | Carrier handling fees not included | In-case loop
154 | Shipping, fees & discounts | Import MVA (estimate) | Import MVA, Alphacool + #81860 orders | 25% of Alphacool + #81860 totals | 1 | Import MVA (est.) | 48.27 | EUR | 530.94 | Estimate | Carrier handling fees not included | External extension
155 | Offsets | Sold parts | Sold Lightloop 360 AIO | Share of the 12 490 kr bundle sale | 1 | Sold (offset) | -1500.00 | NOK | -1500.00 | Sold | See Trade history | In-case loop
156 | Offsets | Sold parts | Sold contact frame | Bought for 60 kr | 1 | Sold (offset) | -150.00 | NOK | -150.00 | Sold | See Trade history | In-case loop
157 | Not project | Personal | Screen protector iPhone 18 Pro Max | 5 pcs, HD glass | 1 | AliExpress | 94.59 | NOK | 94.59 | Awaiting delivery |  | Not project
 |  |  |  |  |  |  |  | Total | 20005.78
 | Legend: blue = price as shown on receipt/order page (input). Black = formula. Multi-item order totals are split across their lines in proportion to the listed unit prices.
 | All prices incl. MVA where the shop charged it. MDPC-X, Order #81860 and (likely) Alphacool charged none; see the Import MVA estimate line.

Sheet: Rev 4b BOM
# | Board | Refs | Part | Value / spec | Qty needed | Components # | Status (from Components) | Note
1 | Board 1 | F1–F3 | 5x20 PCB fuse clip holder | 25.5x9 mm, clip pins nudged to 9 holes | 3 | 107 | Awaiting delivery
2 | Board 1 | F1 | Glass fuse 5x20 slow blow | 3.15 A (pump) | 1 | 104 | Awaiting delivery
3 | Board 1 | F2, F3 | Glass fuse 5x20 slow blow | 1 A (fans; solenoid + valve) | 2 | 103 | Awaiting delivery
4 | Board 1 | C1 | Electrolytic capacitor | 470 uF 25 V, legs bent to 5.08 mm | 1 | 100 | Awaiting delivery
5 | Board 1 | M1, M2, M3 | IRF4905 P-channel MOSFET | TO-220; valve open, valve close, pump 2 high-side | 3 | 85 | Processing
6 | Board 1 | M4 | IRLB8721 N-channel MOSFET | TO-220; solenoid low-side | 1 | 84 | Awaiting delivery
7 | Board 1 | T1, T2, T3 | BC547 NPN transistor | TO-92 gate drivers | 3 | 86 | Processing
8 | Board 1 | D1, D2 | 1N5819 Schottky diode | Valve output flyback | 2 | 88 | Awaiting delivery
9 | Board 1 | R1, R3, R5 | Resistor 47k | Fuse-sense divider top | 3 | 136 | Ordered
10 | Board 1 | R2, R4, R6 | Resistor 20k | Fuse-sense divider bottom | 3 | 136 | Ordered
11 | Board 1 | R7, R8, R9, R10 | Resistor 10k | Gate pull-ups x3, M4 gate pull-down | 4 | 94 | Awaiting delivery
12 | Board 1 | T1b, T2b, T3b | Resistor 1k | Base resistors | 3 | 136 | Ordered
13 | Board 1 | T1p, T2p, T3p | Resistor 100k | Base pull-downs | 3 | 136 | Ordered
14 | Board 1 | R11 | Resistor 100 ohm | M4 gate resistor | 1 | 136 | Ordered
15 | Board 1 | X1–X4 | KF128 4P screw terminal | 2.54 mm, slid together along row AA | 4 | 115 | Awaiting delivery
16 | Board 1 | FAN1, FAN2, PUMP | 4-pin PWM fan header | Fans rotated, pin 1 GND on the right | 3 | 138 | Bought
17 | Board 1 | RIB | Right-angle shrouded IDC header 34-pin | To Board 2, pin 1 at K21 | 1 | 139 | To order
18 | Board 1 | — | Prototype PCB 6x8 cm | Board 1 (power) | 1 | 143 | Bought
19 | Board 2 | MEGA, RIB | Right-angle shrouded IDC header 34-pin | Mega ribbon (pin 1 at D1) + Board 1 ribbon (pin 1 at K21) | 2 | 139 | To order
20 | Board 2 | SHT, PANEL, DISP, NTC | 2.54 mm single-row male header | 18 pins: 1x4, 1x6, 1x6, 1x2 cut from strips | 18 | 116 | Processing
21 | Board 2 | Cs1–Cs3, Cn1–Cn3, Cb1, Cb2 | Ceramic capacitor 100 nF | Sense, NTC and button filters | 8 | 98 | Awaiting delivery
22 | Board 2 | C5V | Electrolytic capacitor | 100 uF 16 V, 5 V bulk | 1 | 137 | Ordered
23 | Board 2 | R1–R6, R9, R10 | Resistor 10k | NTC pull-ups x3 (1%), tach pull-ups x3, button pull-ups x2 | 8 | 94 | Awaiting delivery
24 | Board 2 | R7, R8 | Resistor 4.7k | I2C pull-ups | 2 | 95 | Awaiting delivery
25 | Board 2 | R11, R12, R16, R18, R20, R22 | Resistor 1k | Button series x2, SPI divider top x3, CS divider top | 6 | 136 | Ordered
26 | Board 2 | R17, R19, R21, R23 | Resistor 2k | SPI divider bottom x3, CS divider bottom | 4 | 136 | Ordered
27 | Board 2 | R13 | Resistor 220 ohm | LED red | 1 | 136 | Ordered
28 | Board 2 | R14, R15 | Resistor 150 ohm | LED green, LED blue | 2 | 136 | Ordered
29 | Board 2 | — | Prototype PCB 6x8 cm | Board 2 (logic) | 1 | 143 | Bought
30 | Cables | Ribbons | IDC female socket 34-pin | 2 for Board 1-2, 1 for the Mega ribbon | 3 | 140 | To order
31 | Cables | Ribbons | Flat ribbon cable 28 AWG | About 20 cm Board 1-2 plus the Mega run | 1 | 142 | Bought
32 | Cables | Mega end | Dupont male crimp pins | 32 conductors into the Mega headers | 32 | 118 | Processing
33 | Cables | Mega end | Dupont multi-pin housings | 1x6 x2, 1x4 x3, 2x2 x1 (1x2 from 2-pin stock) | 6 | 141 | To order
34 | Cables | Mega end | Dupont 2-pin housing | D2/D3 PWM group | 1 | 121 | Processing
35 | Cables | Mega end | Dupont 1-pin housing | D49 display CS, next to the SPI 2x2 | 1 | 120 | Processing
36 | Cables | Board 2 leads | Dupont female crimp pins | 18: SHT 4, PANEL 6, DISP 6, NTC 2 | 18 | 119 | Processing
37 | Cables | C1 | GX12 aviation plug male + female 2P | 12 V feed, both ends | 2 | 109 | Awaiting delivery
38 | Cables | C5 | GX12 aviation plug male + female 3P | GPU block NTC, both ends | 2 | 110 | Awaiting delivery
39 | Cables | C2 | GX12 aviation plug male + female 4P | SHT31 x2, both ends | 2 | 111 | Awaiting delivery
40 | Cables | — | GX12 aviation plug male + female 5P | Spare: C4 moved to 6P | 0 | 112 | Awaiting delivery
41 | Cables | C3, C4 | GX12 aviation plug male + female 6P | At the 570X bracket only: C3 panel, C4 display + CS; both hardwired into the box | 2 | 113 | Awaiting delivery
42 | Cables | C1 | Inline mini blade fuse holder | 5 A, at the PSU end of the 12 V feed | 1 | 108 | Awaiting delivery
43 | Cables | C1 | RVV 2-core 18 AWG | 12 V feed run | 1 | 124 | Awaiting delivery
44 | Cables | C1 | UL2464 2-core 20 AWG | 12 V pigtail into the KF128 | 1 | 126 | Awaiting delivery
45 | Cables | C2–C5 | UL2464 6-core 24 AWG | Runs into the case; C4 uses all six cores | 1 | 127 | Awaiting delivery
46 | Off-board | Display | ST7789 IPS display | 1.69" or 1.9", whichever you pick | 1 | 133 | Ordered
47 | Off-board | Display end | Resistor 10k + ceramic 100 nF | RES pull-up and power-on RC at the display (CS is wired, BLK to VCC) | 1 | 94 | Awaiting delivery
48 | Off-board | Case | SHT31 module | A = 0x44 top-rear, B = 0x45 mid-case | 2 | 82 | Processing
49 | Off-board | Top panel | RGB LED 5 mm common cathode | Status LED | 1 | 89 | Processing
50 | Off-board | Solenoid | 1N5819 Schottky diode | Across the coil, cathode to + | 1 | 88 | Awaiting delivery
51 | Off-board | Sensors | Bykski B-PD5-TMR temperature probe | Outdoor rad, valve outlet, GPU block | 3 | 34 | Awaiting delivery
52 | Off-board | Controller | MEGA2560 R3 | Controller | 1 | 79 | Awaiting delivery
53 | Off-board | Stack | Nylon M3 standoffs | Board gap 32 mm | 1 | 132 | Awaiting delivery
54 | Off-board | Insulation | Heat shrink 3:1 dual-wall | GX solder cups, pigtails, coil diode | 1 | 129 | Awaiting delivery
55 | Off-board | Box entry | Grommet or cable gland + zip ties | Strain relief for hardwired C3 and C4 into the box | 2 |  | Not in list
 | Qty needed counts parts on both boards plus off-board items for rev 4b with display CS, no spares. Blue = input. Status is pulled live from Components column K using the # in column G.
 | Bought but not used in rev 4b: relay modules (12 V, 24 V), SHT30 modules, SB560 diodes, 3296W trimmers, ferrite rings, 0.91" OLEDs.
