darkmass2156/PCS/CHANGELOG.md

# Changelog

Newest first. Each entry says which revision it belongs to:
**FW** = firmware (`firmware/controller/version.h`), **LOGIC** = control logic rev,
**HW** = hardware rev, **SCH** = schematic rev, **DISP** = display software rev (`DISPLAY_REV`),
**BENCH** = bench sketches (`tests/common/bench.h`),
**DOC** = documentation only.
Change notes with the reasoning live in `docs/changes/`. `CLAUDE.md` is the authoritative spec.

## Revision index
| Date | FW | Disp | Bench | Logic | HW | Schematic | Git tag |
|---|---|---|---|---|---|---|---|
| 2026-11-06 | 0.9.7e + lite 1.8 | 10 | 1.9 | 2 | **6b**, installed in the PC, display 1 MHz | rev11 | — |
| 2026-11-06 | 0.9.7d + lite 1.8 | 10 | 1.9 | 2 | **6b**, passive LG rebuild, fan 2 tach only | rev11 | — |
| 2026-11-06 | 0.9.7c + lite 1.8 | 10 | 1.9 | 2 | **6b**, passive LG rebuild, fan 2 tach only | rev11 | — |
| 2026-11-06 | 0.9.7b + lite 1.8 | 10 | 1.9 | 2 | **6b**, passive LG rebuild, fan 2 tach only | rev11 | — |
| 2026-11-06 | 0.9.7a + lite 1.8 | 10 | 1.9 | 2 | **6b**, passive LG rebuild | rev11 | — |
| 2026-11-05 | 0.9.7 + lite 1.8 | 10 | 1.9 | 2 | **6b**, V1 not fitted, two fan tachs | rev11 | `fw-v0.9.7` |
| 2026-11-05 | 0.9.6 + lite 1.8 | 10 | 1.9 | 2 | **6b**, V1 not fitted, two fan tachs | rev11 | `fw-v0.9.6` |
| 2026-11-05 | 0.9.5 + lite 1.8 | 10 | 1.9 | 2 | **6b**, V1 not fitted, two fan tachs | rev11 | `fw-v0.9.5` |
| 2026-11-05 | 0.9.4 + lite 1.8 | 10 | 1.9 | 2 | **6b**, V1 not fitted, one fan tach | rev11 | `fw-v0.9.4` |
| 2026-11-04 | 0.9.3 + lite 1.8 | 10 | 1.9 | 2 | **6b**, V1 not fitted, one fan tach | rev11 | `fw-v0.9.3` |
| 2026-11-04 | 0.9.2 + lite 1.8 | 9 | 1.9 | 2 | **6b**, V1 not fitted, one fan tach | rev11 | `fw-v0.9.2` |
| 2026-11-04 | 0.9.1 + lite 1.7 | 9 | 1.9 | 2 | **6b**, V1 not fitted, one fan tach | rev11 | `fw-v0.9.1` |
| 2026-11-04 | 0.9.0 + lite 1.7 | 9 | 1.9 | 2 | **6b**, V1 not fitted, one fan header | rev11 | `fw-v0.9.0` |
| 2026-11-04 | 0.8.4 + lite 1.7 | 8 | 1.9 | 2 | **6b**, V1 not fitted, tach direct + RC | rev11 | `fw-v0.8.4` |
| 2026-11-04 | 0.8.3 + lite 1.7 | 8 | 1.9 | 2 | **6b**, V1 not fitted, tach direct | rev11 | `fw-v0.8.3` |
| 2026-11-04 | 0.8.2 + lite 1.7 | 8 | 1.9 | 2 | **6b**, V1 not fitted, tach direct | rev11 | `fw-v0.8.2` |
| 2026-11-03 | 0.8.1 + lite 1.7 | 8 | 1.9 | 2 | **6b**, V1 not fitted | rev11 | `fw-v0.8.1` |
| 2026-11-03 | 0.8.0 + lite 1.6 | 8 | 1.9 | 2 | **6b**, V1 not fitted | rev11 | `fw-v0.8.0` |
| 2026-11-03 | 0.7.1 + lite 1.6 | 8 | 1.9 | 2 | **6b** (PW + LG, RES D47, dividers 330/680) | rev11 | `fw-v0.7.1` |
| 2026-11-03 | 0.7.0 + lite 1.6 | 8 | 1.9 | 2 | **6b** (PW + LG, RES D47, dividers 330/680) | rev11 | `fw-v0.7.0` |
| 2026-11-02 | 0.6.1 + lite 1.5 | 7 | 1.8 | 2 | **6b** (PW + LG, RES D47, dividers 330/680) | rev11 | `fw-v0.6.1` |
| 2026-11-02 | 0.6.0 + lite 1.5 | 7 | 1.8 | 2 | **6b** (PW + LG, RES D47, dividers 330/680) | rev11 | `fw-v0.6.0` |
| 2026-11-01 | 0.5.4 + lite 1.5 | 7 | 1.8 | 2 | **6b** (PW + LG, RES D47, dividers 330/680) | rev11 | `fw-v0.5.4` |
| 2026-11-01 | 0.5.3 + lite 1.4 | 7 | 1.8 | 2 | **6b** (PW + LG, RES D47, dividers 330/680) | rev11 | `fw-v0.5.3` |
| 2026-11-01 | 0.5.2 + lite 1.4 | 7 | 1.8 | 2 | **6b** (PW + LG, RES D47, dividers 330/680) | rev11 | `fw-v0.5.2` |
| 2026-11-01 | 0.5.1 + lite 1.4 | 7 | 1.7 | 2 | **6b** (PW + LG, RES D47, dividers 330/680) | rev11 | `fw-v0.5.1` |
| 2026-11-01 | 0.5.0 + lite 1.4 | 7 | 1.7 | 2 | **6b** (PW + LG, RES D47, dividers 330/680) | rev11 | `fw-v0.5.0` |
| 2026-10-28 | 0.4.9 + lite 1.3 | 6 | 1.6 | 2 | 4b + CS mod + SHT30, dividers 330/660 | rev11 | `fw-v0.4.9` |
| 2026-10-28 | 0.4.8 + lite 1.2 | 6 | 1.5 | 2 | 4b + CS mod + SHT30, dividers 330/660 | rev11 | `fw-v0.4.8` |
| 2026-10-28 | 0.4.7 + lite 1.1 | 6 | 1.5 | 2 | 4b + CS mod + SHT30, dividers 330/660 | rev11 | `fw-v0.4.7` |
| 2026-10-27 | 0.4.6 + lite 1.0 | 6 | 1.4 | 2 | 4b + CS mod + SHT30, dividers 330/660 | rev11 | `fw-v0.4.6` |
| 2026-10-27 | 0.4.5 | 6 | 1.4 | 2 | 4b + CS mod + SHT30, dividers 330/660 | rev11 | `fw-v0.4.5` |
| 2026-10-26 | — | — | 1.4 | 2 | 4b + CS mod + SHT30 | rev11 | — |
| 2026-10-26 | — | — | 1.3 | 2 | 4b + CS mod + SHT30 | rev11 | — |
| 2026-10-17 | 0.4.4 | 6 | 1.2 | 2 | 4b + CS mod + SHT30 | rev11 | `fw-v0.4.4` |
| 2026-10-17 | 0.4.3 | 6 | 1.2 | 2 | 4b + CS mod + SHT30 | rev11 | `fw-v0.4.3` |
| 2026-10-17 | 0.4.2 | 5 | 1.2 | 2 | 4b + CS mod + SHT30 | rev11 | `fw-v0.4.2` |
| 2026-10-17 | 0.4.1 | 4 | 1.2 | 2 | 4b + CS mod + SHT30 | rev11 | `fw-v0.4.1` |
| 2026-10-17 | 0.4.0 | 3 | 1.2 | 2 | 4b + CS mod + SHT30 | rev11 | `fw-v0.4.0` |
| 2026-10-17 | 0.3.1 | 2 | 1.1 | 2 | 4b + CS mod + SHT30 | rev11 | `fw-v0.3.1` |
| 2026-10-17 | 0.3.0 | 1 | 1.1 | 2 | 4b + CS mod + SHT30 | rev11 | `fw-v0.3.0` |
| 2026-10-17 | 0.2.0 | — | 1.1 | 2 | 4b + CS mod + SHT30 | rev11 | `fw-v0.2.0` |
| 2026-10-17 | 0.1.0 | — | 1.0 | 2 | 4b + CS mod + SHT30 | rev11 | `fw-v0.1.0` |
| 2026-10-17 | — | — | — | 2 | 4b + CS mod + SHT30 | rev11 | `logic-r2` |
| 2026-10-17 | — | — | — | 1 | 4b + CS mod | rev10 | `logic-r1` |

---

## DOC — 2026-11-06
- `tools/pc_serial/pcs_term.py`: PC serial terminal that opens the port with DTR off (no Mega reset on connect), optional log.

## FW 0.9.7e — 2026-11-06 (HW 6b, installed in the PC)
- `DISP_SPI_HZ` 4 → 1 MHz: in the PC the display shows artifacts at 2 MHz and crashes at 4 MHz (Vlad). Comment notes
  that AVR SPI rounds down to 8/4/2/1/0.5 MHz (1.5 MHz = 1 MHz, 3 MHz = 2 MHz). Boot splash and mode changes are slower.

## FW 0.9.7d — 2026-11-06 (HW 6b)
- Bug: anything starting with `t` (`tout-15`, `t3 -15`) ran the `t` command ("TEST refused"). `?` `h` `t` `x` must now be
  sent alone; SIM names are matched first, `=` optional (`Rad -15`).
- New SIM override `Tout=..` (T_out held; feasibility and the display use it), cleared by `clr` / 30 min like the others.
- Serial names: T1 = Ret (loop return), T2 = Mix (V2 outlet), T3 = Rad (outdoor rad) in the status line, `?`, fault and
  alarm names (`NTC-MIX`, `MIX-LOW`, `RET-LOW`, `RET-LOW-IDLE`). SIM accepts Ret/Mix/Rad and T1/T2/T3. CSV columns unchanged.

## FW 0.9.7c — 2026-11-06 (HW 6b)
- Fans (Vlad): `FAN_PWM_MIN` 30 → 10 %. Kick-start (60 % / 3 s) replaced by boosts at 30 %: 5 s on every start from 0,
  5 s every 10 s while FAN2 reads 0 rpm, 10 s exercise after 60 min at minimum. Boosts are timed every loop pass
  (the old kick only ended at the next V2 control period in RUN).
- Fan tunables moved to a "FAN TUNING - edit here" block at the top of `config.h`.

## FW 0.9.7b — 2026-11-06 (HW 6b)
- `FAN1_TACH_FITTED 0`: fan 1 out of the tach / stall alarm / kick-start / display (Vlad). On PW the FAN1 header tach pin is
  tied to the PWM net: with fan 1's tach wire on it the fan modulates its own PWM and ticks. Wire left unplugged.
- D18 plain INPUT when unfitted (no pull-up on the PWM net). Serial txt shows `fan  30%  rpm 1020`; csv rpmF1 field empty.
- Flip to 1 after the PW fix; nothing else to change.

## FW 0.9.7a — 2026-11-06 (HW 6b, passive LG rebuild)
Work-in-progress letter: stays 0.9.7x until the rebuilt board works end to end.
- Buttons D30/D32 `INPUT_PULLUP` (the LG 10k pull-ups and 100 nF are gone, only the 1k in series stay). Fixes dead buttons.
- D34/D36 (old SHT30 pins) `INPUT_PULLUP`, never driven.
- Fuse sense (no filter caps now): one channel every 10 ms, first read discarded, average of 8 (`FUSE_AVG`, `FUSE_READ_MS`).
- Unchanged: NTC open-pin check (100 µs internal pull-up, harmless with the 100 nF), SPI 4 MHz, display RES hard reset at boot
  only + soft re-init, tach pin modes, LED G/B mapping (G D11 / B D10 until checked on the rebuilt board).

## FW 0.9.7 — 2026-11-05: V2 positioning in test mode
- `dg<deg>`, `o<mm>`, `o<pct>%` move V2 to an absolute angle / port opening / outdoor share (from the estimate, play
  added on a reversal). The old `o<ms>` / `c<ms>` raw runs are now `+<ms>` / `-<ms>`.
## FW 0.9.6 — 2026-11-05: readable serial log
- Default 1 Hz output is now a labelled, aligned status line (`txt`); `csv` switches back to CSV (EEPROM 8).
  Faults/alarms by short name instead of hex. V2 port opening (mm) and outdoor share (%) added to both formats
  and to the test-mode echo; CSV gains `V2mm,V2out%` after `V2deg`.
## FW 0.9.5 — 2026-11-05: fan 1 tach back, with a low-duty fallback
- Fans on separate headers again (`FAN1_TACH_FITTED 1`). Bench sweep: fan 1's tach is swamped by the PWM below 30 %
  (raw ~380k, no valid pulses at 20 %), clean from 30 %. Below `FAN1_TACH_MIN_PCT` fan 1 reports fan 2's rpm.
  (`FAN_PWM_MIN` is 30, so this only matters during test-mode duties below 30.)
- `05_fan_pwm_tach`: serial input is line based (f10, F10, "f 10" all work).
## FW 0.9.4 — 2026-11-05: fan minimum + kick-start
- `05` sweep: 20 % from standstill = fan 1 stopped, fan 2 ~330 rpm; 30 % ramps to a steady ~1000 rpm, 70 % ~2040.
  Tach readings clean (per-pulse range ±1–3 %). `FAN_PWM_MIN` 20 → 30.
- Kick-start: fan at 0 rpm with a target below 60 % → 60 % for 3 s first, retried every 10 s.
## FW 0.9.3, DISP 10 — 2026-11-04
- Serial SIM overrides `T1= T2= T3= TR= DP=` (control + faults use them, SIM shown, `clr` / 30 min clears), `m1..m3`
  sets the mode as the buttons do. For dry runs of every fault path without heating or cooling anything.
- Reset counters in EEPROM 4..7 (WDT / BOR / EXT / POR), printed at boot and in `?`, `rc` clears. Bench: occasional
  full reboots, cause unknown.
- Display self-heal no longer blinks: soft re-init without SWRESET/SLPOUT and in-place repaint instead of the full
  redraw every 5 min (bench: "refreshes sometimes").
- 1.69" 280x240 variant removed (`screens.*`, `DISPLAY_VARIANT`, preview); 1.9" only. V1: run without (decided).
## FW 0.9.2 + lite 1.8 — 2026-11-04: all sensors calibrated to one another
- `15_cal_all` run (10 min, still air, reference = median of the SHTs 23.10 °C / 33.39 %): NTC T1/T2/T3 −0.15 / +0.67 /
  +0.54 °C; SHT A +0.44 °C / +0.50 %, B 0 / −0.38 %, R −0.32 °C / 0. Replaces the single-reading 2026-11-03 offsets.
  Same values in lite170, 02, 10 and 12.
## BENCH — 2026-11-04: `15_cal_all`
- New sketch: one 10 min run averages all three NTCs and all three SHTs side by side and prints every offset against
  the median of the SHTs (T and RH) as `config.h` lines.
## FW 0.9.1 — 2026-11-04: tach sampled instead of edge interrupts
- Timer4 samples the tach pins every ~250 µs, a level change counts after 3 equal samples (`TACH_DEBOUNCE`).
  Replaces the INT/PCINT edge filter: bench showed per-pulse rpm exactly 2:1 (667–1410) = single pulses lost when a
  bounce on the slow RC edge was read as a rise. Same method in `05_fan_pwm_tach` (raw edges still printed).
## BENCH — 2026-11-04: `05_fan_pwm_tach` on the display
- Duty, filtered rpm (big), raw rpm (red when far above filtered) and the live tach line level per fan on the 1.9"
  panel (CS 49, DC 53, RES 47, 4 MHz). Copies `fonts.h` / `scr_gfx.*` from the controller.
## FW 0.9.0, DISP 9 — 2026-11-04: one fan header
- Both fans on the FAN2 header with a Y-splitter (`FAN1_TACH_FITTED 0`): D18 not read, no FAN 1 STALL alarm,
  rpmF1 column 0; Mode 3 FAN row shows one rpm.
## FW 0.8.4 — 2026-11-04
- Tach filter also needs the line HIGH ≥ 1 ms before a counted falling edge (`TACH_HIGH_MIN_US`, CHANGE interrupts).
  Bench after 10k + 100 nF: fan 2 read exactly double above ~1000 rpm (glitch on the slow rising edge counted).
  Same filter in `05_fan_pwm_tach`. Fan 1: intermittent contact to FAN_PWM (750k bursts), hardware.
## FW 0.8.3 — 2026-11-04
- Tach edge filter in all three ISRs (fans, P2): pin still LOW + 3 ms lockout (`TACH_LOCKOUT_US`), as in `05`.
  Bench: raw 750k rpm at 10 % = every PWM cycle coupled onto both fan tachs; hardware RC (10k + 10 nF at D18/D19,
  1k series in FAN_PWM) to follow.
## FW 0.8.2 — 2026-11-04
- Fan tachs rewired straight PW C22/D22 → Mega D18/D19 (bypassing LG and its 10k pull-ups J7/J8): D18/D19 now
  `INPUT_PULLUP`, also in `05_fan_pwm_tach`. Bench: TACH2 picked up the 25 kHz fan PWM on the LG path.
## BENCH — 2026-11-04: `05_fan_pwm_tach` raw vs filtered tach
- Prints raw rpm (every falling edge) next to filtered rpm (edge still LOW when the ISR reads it, 3 ms lockout) to
  show PWM noise coupling onto the tach lines (bench: tach readings far off).
## BENCH — 2026-11-03: averaged SHT calibration in `02_sht31_dewpoint`
- BTN1 long: 10 min run averaging the raw T/RH of A, B and R, then prints each sensor's offset to the median of the
  three as `#define SHT_T_OFFSET_*` / `SHT_RH_OFFSET_*`. The breath marker moved to serial `b`.
- The FW 0.8.1 offsets came from one reading (R drifted 0.24 °C right after); they stay until this run replaces them.
## FW 0.8.1 + lite 1.7 — 2026-11-03: SHT calibration to the median
- All three SHTs side by side, raw: A 21.45 °C 33.5 %, B 22.51 °C 34.8 %, R 22.64 °C 35.0 %. Each pulled to the median
  (22.51 °C, 34.8 %): A +1.06 °C / +1.3 % RH, B 0 / 0, R −0.13 °C / −0.2 % RH. New `SHT_T_OFFSET_*` (temperature was
  not calibrated before). Same in lite170, 02, 10 and 12. Room SHT30 on D38/D40 confirmed reading.
## BENCH — 2026-11-03: `02_sht31_dewpoint` soft-bus scan
- At boot and on BTN2 long: D38/D40 idle levels with the module pull-ups only, and an address scan 0x08..0x77 as wired
  and swapped (finds an SHT3x on 0x45, or a different chip sold as SHT30: 0x40 SHT2x/HTU21, 0x38 AHT).
  Bench: SHT30 straight on the Mega still NACKs on 0x44.
## FW 0.8.0 — 2026-11-03: V1 dropped
- `V1_FITTED 0`: SEN never driven, V2 alone shuts the outdoor branch; flowing = P2 on and V2 above the edge.
  Reason and safety consequence: `docs/changes/v1_dropped.md`.
## FW 0.7.1 — 2026-11-03
- SHT30 moved to D38 (SDA2) / D40 (SCL2), wired straight to the Mega header; the LG path on D34/D36 never answered.
  Same in `02_sht31_dewpoint`. The `?` room probe follows the pins.
## FW 0.7.0 + lite 1.6, DISP 8, BENCH 1.9 — 2026-11-03
- Serial test mode (`t` / `x`, state TEST, Mode 1 idle only): fans `f`, P2 `p`, V1 `v1`/`v0`, V2 `o`/`c`/`k`/`s`.
  Faults stay armed; leaves on x, a button, a fault, 12V loss or 30 min idle. `h` prints the commands.
  Serial input is now line based (CR/LF or 50 ms silence).
- Display rev 8 (320x170): fan alarms (fan fuse, fan 1/2 stall) as a maroon ALARM banner in Modes 1/2 and the Mode 3
  bottom line; grey SERIAL TEST MODE banner. No LED change for alarms.
- LED: green and blue are swapped in the build (Mode 2 breathed green) → `PIN_LED_G` 11 / `PIN_LED_B` 10, same in
  `bench.h` (1.9). All LED output scaled to 80 % (`LED_BRIGHTNESS_PCT`, lite170 `BENCH_LED_PCT`).
## FW 0.6.1 — 2026-11-02
- V2 close travel measured: play 726 ms + 1300 + 1800 + 1950 ms, same as open. `V2_T_CLOSE_MS` 5050 confirmed
  (was ASSUMED); no value change.
## FW 0.6.0 — 2026-11-02: V2 calibrated
- V2 tunables from the bench (`docs/changes/v2_calibration.md`): travel 5050 ms after a 725 ms play, dead zone
  1300 ms from bypass (edge 23.2°), park 10 s on VC. Direction confirmed (VO = outdoor, VC = bypass).
- Opens from below the edge cross the dead zone; regulation closes only to the edge; sleep counts time shut at the
  edge. Start rate limit from the edge. Gains / max pulses scaled to the real travel (tune on the loop).
## BENCH — 2026-11-02: valve tests without fuse sense
- `07_valve`, `10_v2_calibration`: `FUSE_CHECK 0` (default) no longer refuses to drive when S1/S3 read low; 1 restores
  the check. Bench: 12 V present on all fuses but S3 not seen on A2 (fuse-sense path open, to be traced).
- Bench find: the VO driver had a BC557 (PNP) fitted instead of the BC547 (C-B junction held the gate at 0.8 V).
## FW 0.5.4 + lite 1.5 — 2026-11-01
- Status LED (scheme 1): the alarm flash (100 ms yellow every 2 s) is removed (Vlad). Alarms show on the display
  and as `#` serial lines; the LED shows mode, fault and the mode-change pulses only.
## BENCH — 2026-11-01: `14_led_colors`
- New sketch to map the status LED colours on the buttons: firmware colours with per-channel gains, raw mixer,
  white balance (prints `LED_GAIN_*` lines), hue sweep. Bench: green and blue very dim, white shows purple.
## FW 0.5.3 — 2026-11-01
- `?` adds a room SHT30 diagnostic: D34/D36 idle levels with the external pull-ups only, then an ACK probe of
  0x44 / 0x45 (status register + CRC) with the pins as wired and swapped, and the current room reading.
  Bench: SHT30 on D34/D36 not reading.
## FW 0.5.2, BENCH 1.8 — 2026-11-01
AVR build OK, 0 warnings. Bench report: T2 (A4) read a steady ~17.5 °C whatever was plugged in; T3 (A3) read 17.6 °C
with the probe that reads 25.9 °C on T1 (586 instead of ~503 counts: ~7.2k pull-up or ~3.7k in series on that path).

### Added
- NTC open-pin check (safety): after each read the internal pull-up is on for ~100 µs; a floating pin (no connection
  from the LG node to the Mega) reads as open → "--" and, after 2 s, the NTC fault, instead of a plausible fake
  temperature on what may be the control sensor. `?` prints PIN FLOATING. `NTC_FLOAT_DELTA` = 40.
- `01_ntc` prints PIN FLOATING the same way.

## FW 0.5.1 — 2026-11-01
AVR build OK, 0 warnings.
### Added
- `?` prints each NTC as the ADC sees it: filtered counts, resistance (10k pull-up), °C, valid — to chase a wrong
  T1 (A5) reading. `NtcReading.adc` added.

## DOC — 2026-11-01
- `docs/controller_pinout_rev6b.md` (Vlad): component → LG → ribbon → housing H1–H8 → Mega for every wire.
  Checked against `config.h`: all pins match (buttons D30 / D32, RES D47, SHT30 D34 / D36, ...).

## FW 0.5.0, DISP rev 7, lite170 1.4, BENCH 1.7, HW rev 6b — 2026-11-01
From Vlad's change note `docs/changes/hw_rev6b.md` (hardware rev 6b; logic rev 2 unchanged).
AVR build of all 16 sketches (`tools/avr_build/build.sh all`): OK, 0 warnings; controller also built with
`LED_SCHEME 2`, `DISPLAY_VARIANT 1`, every SIM switch. Not yet run on the rev 6b boards.

### Changed (FW)
- `HW_REV` "6b". Display: the 1.9" 320x170 is the controller's panel now (`DISPLAY_VARIANT 2`, default):
  `screens170.*` moved from lite170 into `firmware/controller/` (canonical) and is used by `display.cpp`;
  the 1.69" layouts stay as variant 1. `DISP_TARGET_ILI9341_SIM` default 0 (real ST7789).
- Display RES on **D47** (`PIN_DISP_RST`); `init()` pulses it. The 5-min self-heal re-init is now followed by a
  full redraw.
- SHT31 bus: `Wire.setWireTimeout(25000, true)`, and after a timeout a bus recovery (9 SCL pulses, STOP, Wire
  restart; counted, shown by `?`).
- NTC open/short judged on the raw ADC (< 8 / > 1015): invalid at once (the filter restarts on recovery);
  the fault still needs 2 s (safety rule 5).
- Serial `#` event lines: state / mode changes, and every fault and alarm by name (all active ones at the end of
  the boot grace, then each ON / off), also with `?`.
- Bench switches `SIM_FORCE_12V`, `SIM_FAKE_P2_TACH` no longer need `NTC_TRIMPOT_SIM`; new `SIM_FAKE_FAN_TACH`.
  Any SIM switch marks the banner and the display.
- `LED_SCHEME 2`: the rev 6b proposed LED table, selectable (PROPOSAL; scheme 1 stays the default).

### Changed (lite170 1.4, bench 1.7)
- RES D47 in lite170, `06_display`, `11_ui_dev`, `12_disp170_sht31`. 25 ms Wire timeout + bus recovery in lite170
  and `12_disp170_sht31`; 25 ms in `02`, `10`. `06_display` and `11_ui_dev` default to the 1.9" (variant 2);
  `11_ui_dev` runs the 320x170 screens.

### Added
- `tests/13_led_pins`: D9 / D10 / D11 one at a time with the pin printed, white, off; PWM fades; colour sample of
  both LED schemes.
- CLAUDE.md: hardware rev 6b (PW/LG boards, pin map with D47, 330/680 dividers, BLK not connected, AL pins left
  open, PC-USB grounding and the Mac ground loop), LED proposal recorded as OPEN.

## FW 0.4.9, lite170 1.3, BENCH 1.6 — 2026-10-28
AVR build of all sketches (`tools/avr_build/build.sh all`): OK, 0 warnings.

### Changed
- SHT RH calibration raised to A 0x44 **+1.15 % RH**, B 0x45 **−1.15 % RH** (was ±0.75), everywhere the offsets
  live: `config.h`, lite170, `02_sht31_dewpoint`, `10_v2_calibration`, `12_disp170_sht31`. Displayed RH, dew points,
  the night log and the control logic all use the corrected values.

## FW 0.4.8, lite170 1.2 — 2026-10-28
**First real AVR build** of everything: avr-gcc 7.3.0 (same as the IDE), ArduinoCore-avr 1.8.8, Adafruit ST7735/ST7789
1.12.0, GFX 1.13.0, BusIO 1.17.4. All 15 sketches compile and link with `-Wall -Wextra`, 0 warnings after the fixes
below. Flash / RAM: controller 70.4 KB (26.9 %) / 2.9 KB (35.8 %), lite170 60.1 KB / 2.7 KB, 11_ui_dev 56.0 KB / 2.3 KB,
12_disp170_sht31 39.2 KB / 1.4 KB, tests 00–10 ≤ 15.2 KB / 0.6 KB.

### Added
- `tools/avr_build/build.sh` (`all` or one sketch dir): IDE-equivalent Mega 2560 build, flash/RAM report.

### Fixed (no behaviour change)
- `splash.h`: three comparisons mixed `int16_t` with `uint16_t`; on AVR (16-bit `int`) those compare unsigned.
  The values involved are never negative, so the result was right, but they are now explicitly signed.
- `screens.cpp`: unused `seg5()` removed (left over from the segment digits in Mode 2).

## FW 0.4.7, lite170 1.1, BENCH 1.5 — 2026-10-28
Host syntax check of every changed sketch. Not yet compiled for AVR.

### Changed
- SHT RH calibration from Vlad's side-by-side run: A 0x44 +0.75 % RH, B 0x45 −0.75 % RH (R unchanged), added
  to the reading and clamped to 0…100 before the dew point. Firmware (`SHT_RH_OFFSET_A/B/R` in `config.h`),
  lite170, `02_sht31_dewpoint`, `10_v2_calibration`, `12_disp170_sht31` (raw ticks stay raw; the night log stores
  corrected RH).

## FW 0.4.6 + lite170 1.0 — 2026-10-27
Host syntax check (controller, lite170, 11_ui_dev); host render of the lite boot and all three 320x170 screens with
full controller data, a fault and the lite data (`docs/display/preview170_*.png`). Not yet compiled for AVR.

### Added
- `firmware/lite170`: lite case display for the 1.9" (320x170, 4 MHz) with the two SHT31s wired in permanently.
  Boot Pingu → crash → ROG, then Mode 1/2/3 screens re-laid out for 320x170 (`screens170.*`, class `Screens170`).
  Live case T / RH / dew point (highest valid of A/B; 3 bad reads invalidate, first good read validates at boot),
  everything else "--"; NO DEW POINT banner if neither sensor is valid. Buttons and LED as the controller, mode
  and splash bytes in EEPROM 0..3 shared with it. Serial line per read.
- `tools/ui_preview`: framebuffer size per build (`-DFB_W/-DFB_H`), `preview170.cpp`.

### Changed (FW, no visible change on the 1.69")
- `splash.h` works on any panel height: band count from H (15 on 170 rows, last band partial), underline and
  version tucked under the logo when there is no room for the usual gap.

## FW 0.4.5 + HW note — 2026-10-27
Host syntax check. Bench: 1.5 m C4 cable with the new dividers works up to 6 MHz.

### Changed
- HW: display dividers 1k/2k → 330/660 Ω (change note `docs/changes/display_dividers.md`). With 1k/2k the panel
  stayed black on the finished cable, also at 1 MHz.
- `DISP_SPI_HZ` 2 → 4 MHz; `06_display`, `11_ui_dev`, `12_disp170_sht31` follow.

## BENCH 1.4 — 2026-10-26
Host syntax check (both sensor modes) and a host run of the log: 600 samples with a reset and a B dropout,
CSV dump and log page checked (`docs/display/preview_disp170_log.png`). Not yet compiled for AVR.

### Added (`12_disp170_sht31`)
- Night log in EEPROM: every `LOG_INTERVAL_S` (60 s) the average T / RH of A and B, 4 bytes per sample
  (T 0.2 °C over −10…40.6 °C, RH 0.5 %), ring of 1016 samples = 16.9 h. EEPROM 16..4095 only, the firmware's
  bytes 0..3 stay untouched. A reset or power cut while logging resumes with a gap marker, so opening the serial
  monitor doesn't lose or end the log. Serial `d` dumps CSV (sample, minutes, A_T, A_RH, B_T, B_RH), `l` / `x` /
  `e` start / stop / erase.
- Log page (BTN1 cycles live → log → panel check): state, duration, fill, and T and RH charts over the whole log,
  auto-scaled, gaps marked. "LOG n" badge on the live page while logging.

### Changed
- Buttons: BTN2 short = other address (SENSORS 1) / reset counters (SENSORS 2), BTN1 long = new log,
  BTN2 long = stop log. Invert / BGR are serial only (`i` / `b`). `SENSORS 2` is the default again.

## BENCH 1.3 fix 3 — 2026-10-26
### Added (`12_disp170_sht31`)
- `SENSORS 1` (now the default): one sensor on its own screen, address `SINGLE_ADDR`, BTN2 long / serial `a`
  switches 0x44 ⇄ 0x45 (counters reset, sensor re-initialised). Shows T, RH, DP, status register (heater
  flagged), counters and the raw T/RH ticks; serial prints the raw ticks too. `SENSORS 2` keeps the A/B page.

## BENCH 1.3 fix 2 — 2026-10-26
First run on the bench: display OK, but ~60 % failed SHT reads and sensor A at 67 °C / 17.6 % (valid CRC).
### Fixed / added (`12_disp170_sht31`)
- On-screen status said "CRC FAIL" for a read NACK. Errors are now split: trigger NACK (with the Wire code:
  e2 address, e3 data, e5 timeout), read NACK, CRC, timeout; serial `[ok/trig/read/crc/timeout]`.
- Sensors are soft-reset, heater off and status cleared at boot (and on serial `h`); the status register is
  read after each good read and "HEATER ON" shown if bit 13 is set.
- Reads are sequential (A, then B) instead of both triggered together.
- I2C scan at boot and on serial `s`.

## BENCH 1.3 fix — 2026-10-26
### Fixed
- `12_disp170_sht31` black screen with backlight on: `TFT_RST` defaulted to -1, and on a breadboard the module's
  RES floats (no pull-up on most 1.9" modules), so the panel never leaves reset. Default RES pin is now D48
  (via divider). Added a colour flash at boot (R, G, B, white), serial `m` (SPI mode 0/3 + re-init, for
  modules without CS) and `c` (colour flash). Header warns that the module's SDA/SCL are SPI (D51/D52).

## BENCH 1.3 — 2026-10-26
Host syntax check and a host render (`docs/display/preview_disp170_sht31.png`). Not yet compiled for AVR.

### Added
- `tests/12_disp170_sht31`: the 1.9" ST7789 (`init(170, 320)`, landscape 320x170, 2 MHz) and SHT31 A/B on
  hardware I2C (50 kHz, wire timeout). Live T / RH / DP per sensor with ok/NACK/CRC counters, DP spread and
  T A−B, flagged red over 2 °C; non-blocking 2 s read cycle; one Serial line per read. Panel check page
  (frame on all edges, RGB bars). Buttons: BTN1 page, BTN2 invert, BTN1 long BGR, BTN2 long reset counters.
  Same pins as the controller; `TFT_RST` for modules with a RES pin. Uses the dashboard AA fonts.

## FW 0.4.4 — 2026-10-17
Host syntax check of firmware and `11_ui_dev`. Not yet compiled for AVR. Animation unchanged.

### Fixed
- `11_ui_dev`: replaying the boot sequence (BTN2 long / `s` / `p0..p2`) left the dashboard black, because the
  screens still considered every widget drawn and only repainted values that changed. New `Screens::redraw()`,
  called when the splash ends.
- `BootSplash::begin()` resets the hardware scroll and invert, so a restart in the middle of the crash doesn't
  leave the picture shifted or negative (firmware only starts it once, so no visible change there).

## BENCH 1.2 fix — 2026-10-17 (no FW change)
### Fixed
- `11_ui_dev` still always opened with the hobo in Wokwi: the startup penguin came from an EEPROM rotation, and
  Wokwi starts every run with a blank EEPROM. Now picked like the firmware (random, seeded from ADC noise +
  micros, never the last one shown). The seed is printed at boot.

## FW 0.4.3, DISP rev 6 — 2026-10-17
Host-rendered with `tools/ui_preview`; host syntax check of `11_ui_dev`. Not yet compiled for AVR. Boot animation unchanged.

### Fixed
- Mode 2 big numbers clipped on the right: the oblique digits lean 2–5 px past their advance width and the
  glyph cell was cut at the advance (the next glyph painted over the overhang, the last one lost it).
  `make_fonts.py` now widens each cell to hold all its ink; regenerated `fonts.h` (all fonts, 1 px on a few
  DejaVu glyphs like T/Y/r).
- `11_ui_dev` played all three penguins and the ROG sequence three times before the UI (0.4.2 Wokwi startup
  loop). Back to one boot sequence per startup; the rotation across resets stays.

## FW 0.4.2, DISP rev 5 — 2026-10-17
Host-rendered with `tools/ui_preview` (now with a 2 MHz SPI time model); host syntax check of firmware and
`11_ui_dev`. Not yet compiled for AVR.

### Changed
- Boot: Pingu → ROG is now a fast crash (~0.8 s on the real bus, boot ~5.3 s). The 0.4.1 glitch was designed
  for 0.9 s but its full-width redraws took ~3.3 s at 2 MHz, plus 0.5 s to settle. New: crash mid-noot, hardware
  scroll jolts (free), invert flashes, wrong-colour tears, then the screen breaks up in 20 random bands that each
  land on their final ROG content (no separate settle pass).
- Mode 2: big numbers in FreeSans Bold Oblique (replaces the segment digits), labels/values/banner in the
  Mode 1 DejaVu fonts. Chips read EXT / V2 / FAN.
- Mode 3: all text in DejaVu Sans Mono 11 px (replaces 5x7); P&ID, table (12 px rows) and chart (0–35 °C over
  47 rows) re-fitted.
- `fonts.h`: + F_SPORT, F_MONO (~11.8 KB flash total).

### Fixed
- `11_ui_dev` always opened with the hobo: the penguin index started at 0 on every reset (and opening the serial
  monitor resets the Mega). Now rotates across resets via EEPROM addr 3; the Wokwi build plays all three at
  startup; serial `p0`/`p1`/`p2`.

## FW 0.4.1, DISP rev 4 — 2026-10-17
Host-rendered with `tools/ui_preview` (Mode 1 all states, boot frames of all three penguins); host syntax check.
Not yet compiled for AVR.

### Changed
- Mode 1 uses anti-aliased proportional fonts instead of the scaled 5x7 font and segment digits: FreeSans Bold
  33 px for the three big temperatures ("12.3°"), DejaVu Sans Bold 15 px for values, DejaVu Sans 10 px for
  labels. Layout re-fitted; tile values sit right of their measured label.
- Boot: the penguin glitching out and the ROG logo glitching in now overlap. Torn logo bands cut in while the
  penguin still tears, take over with shrinking displacement, then the logo resolves clean in white and a red
  scan crosses it (replaces "black, then grey logo, then white wipe").

### Added
- `fonts.h` + `ftxt()` in `scr_gfx`: 2-bit AA bitmap fonts streamed through one window per field.
  Generator `tools/fonts/make_fonts.py` (DejaVu Sans, GNU FreeSans).

### Fixed
- Red scan: the final white-restore slice could request columns past the logo edge (short address window).
  `rog()` now clamps to the logo width and clips shifted bands to the screen.

## FW 0.4.0, DISP rev 3, BENCH 1.2 — 2026-10-17
New dashboard: one screen per mode, ROG palette, plus the Pingu → glitch → ROG boot sequence. Rendered on the
host with `tools/ui_preview` (all modes: normal, changed values, fault, no 12V; boot frames of all three
penguins), host syntax check of firmware and `11_ui_dev`. Not yet compiled for AVR.

### Added
- `screens.*` (Mode 1 standard, Mode 2 sport/graphite, Mode 3 engineer with P&ID, raw table and a 272 s sweeping
  T2/T_set/DP chart), `scr_gfx.*` (palette, padded text, slanted shapes, segment digits redrawn per segment),
  `scr_data.h` (`UiData`, filled once per second by `display.cpp`).
- Boot: glitch transition (sprite bands torn sideways, scanline noise, two invert flashes, black bands) and the
  ROG logo (dark grey → white wipe with red edge → underline + version). `rog_logo.h` from Vlad's 280x240 artwork
  via `tools/sprites/make_rog.py` (run-length, round-trip checked).
- `tools/ui_preview/`: host framebuffer stand-in for the display library; renders the real display code to
  `docs/display/preview_boot.png` and `preview_modes.png`.

### Changed
- Big values: outside rad, loop 1 return, mixing valve. Smaller: case/room temp, humidity, dew point; cooling W,
  external loop, mixing valve, outdoor fan, distance to dew (T2 − DP max).
- Case values show the highest of the two SHT31s, per value. `K_POT` = 25.0 W/°C (placeholder).
- Clock removed; a 1 Hz dot stays as the frozen-screen check.
- Faults: red banner in Modes 1/2 (rotating through active faults), bottom line in Mode 3.
- `layout.h` removed (each mode has its own layout now). Variant 2 (1.9") has no layouts: compile error.
- BENCH 1.2: `11_ui_dev` runs the real screens and boot sequence with fake data (BTN1 mode, BTN2 scenario,
  BTN1 long animate, BTN2 long boot sequence).

## FW 0.3.1, DISP rev 2 — 2026-10-17
Fixes from the first Wokwi run (ILI9341 part driven by the ST7789 code). Splash re-verified on a strict
framebuffer model (every window filled exactly, nothing off screen); host syntax check for both targets.

### Fixed
- Hobo splash never appeared: the "last shown" index lived in `.noinit` RAM without a validity check, so a
  cold start with RAM at 0 always excluded penguin 0. Now EEPROM addr 3, and the seed mixes an EEPROM boot
  counter (addr 2) because micros()/ADC noise are almost the same every boot.
- Streaks and mirrored fragments in the beak area: the patch was drawn as ~50 separate fillRects, each with
  its own window commands; the corruption pattern (1-2 px streaks, patch pixels mirrored across the screen)
  is window/orientation commands going wrong in transit. Sprites and patches now stream through one address
  window per chunk (~13 windows per splash), opaque.

### Changed
- Vlad's MADCTL mirror support adopted, behind `DISP_TARGET_ILI9341_SIM` (1 = simulator: mirror, BGR, no
  invert; 0 = real ST7789: no mirror, RGB, invert). Banner warns on a simulator build. `11_ui_dev` follows.

## FW 0.3.0, DISP rev 1 — 2026-10-17
First display-software revision. Host syntax check of both variants; the splash was rendered on a simulated
280x240 framebuffer (all three penguins, animation and clear verified). Not yet compiled for AVR.

### Added
- Boot splash: three original Pingu-style penguins (hobo, sit, bow), one at random per boot, never the same twice
  across warm resets. Each noots twice (beak → trumpet / O-lips) in ~3 s, non-blocking, then clears to black.
- `tools/sprites/make_pingu.py` generates `boot_sprite.h` (RLE, 16-colour palettes, beak patches) and
  `docs/display/pingu_preview.png`.
- `DISPLAY_REV` in `version.h`, printed in the banner.

### Changed
- Display is landscape: 280x240 on the 1.69" (in use), 320x170 on the 1.9". `DISP_ROTATION` = 1.
- `layout.h` is now per field {row, labelX, valueX, width}: header row, two columns of five, message row.
- `11_ui_dev`: new layout format (`c` command places a field), truncation warnings, splash replay page.
- `06_display`: landscape, positions fit both variants.
- dTpot with K_POT shows whole degrees ("28 450W") to fit the column.

## FW 0.2.0 + BENCH 1.1 — 2026-10-17
Still not compiled for AVR in the build session (host syntax check of both firmware variants,
normal and SIM, plus all 12 sketches; LED behaviour simulated).

### Changed (FW)
- Status LED scheme decided: Mode 1 white / Mode 2 blue / Mode 3 red slow breathing, 3 fast green pulses
  on a mode change. Driven from `loop()` only so a hang freezes it (watchdog resets 2 s later).
  Overlays kept as ASSUMED: 12V absent off, latched fault fast red, alarm yellow flash.
- Display geometry moved to `layout.h` (one block per variant) so `11_ui_dev` can generate it.

### Added (FW)
- Trimpot test build: `NTC_TRIMPOT_SIM` (3296W 10k as rheostat → −30…+50 °C linear), with optional
  `SIM_FORCE_12V` and `SIM_FAKE_P2_TACH` for a breadboard. SIM shown in banner and on the display.

### Added / changed (BENCH)
- `tests/common/bench.h`: shared outputs-LOW, debounced BTN1/BTN2 (short / long / held / edges), LED helpers.
- All tests 00–09 operable from BTN1/BTN2 (maps in each header). 00 now demos the LED heartbeat and
  simulates a hang (BTN2 long). 03 checks fuse scenarios PASS/FAIL. 07 jogs V2 hold-to-run.
- New `10_v2_calibration`: travel times, backlash, indicator linearity, on-loop flow characteristic sweep
  with DP/T2-floor, stall and 12 V aborts. Prints config lines.
- New `11_ui_dev`: layout tool with scenarios, grid, colour/font page, live edits, draw timings,
  prints a `layout.h` block.

## FW 0.1.0 — 2026-10-17 (logic rev 2, HW 4b + CS + SHT30)
First firmware. **Not yet compiled for AVR** (no toolchain in the build session) — first IDE compile may
surface small errors. Host-side syntax check and a control-logic simulation passed.

### Added
- `firmware/controller/`: safe boot (outputs LOW first), Timer3 25 kHz PWM (0 % = pin held LOW),
  tach via INT2/INT3/PCINT6, fuse sense with hysteresis + debounce, 12V presence.
- NTC T1/T2/T3 (Beta + offset, EMA filter, 2 s out-of-range debounce).
- SHT31 A/B on hardware I2C (50 kHz, Wire timeout) + SHT30 on in-tree soft I2C, CRC, 3-fail/3-good validity.
- Logic rev 2 state machine: NO12V → HOME → IDLE ⇄ START → RUN → STOP, SAFE on latched faults.
- V2 driver: single interlocked VO/VC writer, reversal dead time, θ model with open/close times and
  backlash, every move to bypass = full park with overdrive and re-zero.
- Fan staging after V2, start rate limit, T_out estimate, feasibility guard, sleep/wake.
- Buttons (BTN1 = Mode 1, BTN2 short/long = Mode 2/3, any press acks cleared faults), EEPROM mode.
- Status LED scheme (PROPOSAL, provisional).
- ST7789 display: both variants, 2 MHz re-sent init, one field per loop pass, 5-min non-blocking re-init,
  rotating fault/alarm line.
- CSV log at 1 Hz, `?` status dump, watchdog 2 s, reset-cause capture.
- `tests/00…09` bench sketches; `02` includes the SHT30, `01` can measure Beta with a second point.

### Not implemented
- Freeze guard (PROPOSAL, awaiting decision).

## 2026-10-17 — LOGIC rev 2, SCH rev11, HW SHT30 add-on
Change note: [`docs/changes/logic_rev2.md`](docs/changes/logic_rev2.md)

### Changed
- Modes rewritten as three setpoint modes: Mode 1 = branch off (EEPROM default),
  Mode 2 = load cap T_set = max(T_room + δ, DP + 4), Mode 3 = DP + 4 (BTN2 long).
- Sleep = V2 parked ≥ 10 min; wake = T1 > T_set + 1 °C.
- Feasibility guard: V2 opens only if T_out < T1 − 5 °C; forced bypass if T3 > T1 − 1 °C for 2 min.
- Backstop is now T1 < DP + 2 °C (was T_GPU < T_set − 1).
- DP = max of all valid sources (SHT31 A, B + SHT30 room); alarm on > 2 °C spread.
- Stop order: V2 park → P2 off → V1 off 10 s later.
- V2 position model: separate open/close travel times + backlash, re-zero at bypass.
- P2 fixed at 80 %.
- Naming P1/P2, V1/V2, T1/T2/T3 used everywhere.
- A5 NTC moved from the GPU block to the loop return (T1); SHT30 added on soft I2C D34/D36.

### Removed
- Rev 1 Mode 1 enable/disable thresholds, Mode 2 idle/load margins and the open load-trigger item,
  GPU NTC backstop, separate override mode.

### Spec interpretations (ASSUMED, need confirmation)
- T_out = T3 after the rad has been stagnant `T_OUT_SETTLE_MIN`; held while flowing; a forced bypass
  invalidates it until re-settled.
- Wake also requires feasibility (otherwise it would sleep again 10 min later).
- Mode 3 with < 2 valid DP sources runs the Mode 2 setpoint + alarm.
- Faults still drop V1 and P2 immediately (the 10 s V1 delay is for normal stops only).
- T1 backstop and T2 trip armed only while P2 runs; T1 < DP + 2 with P2 off is an alarm.
- Fault latching: faults latch, any button press clears those whose cause is gone.

### Docs
- `CLAUDE.md` rewritten for logic rev 2; revision tracking section added.
- Schematic rev11 added (`docs/schematics/`); rev10 kept.

## 2026-10-17 — LOGIC rev 1 baseline (tag `logic-r1`)
- Imported the rev 1 spec (`CLAUDE.md`), BOM rev 4b and schematic rev10 as received.
