darkmass2156/PCS/firmware/controller/valve.cpp

#include "valve.h"
#include "config.h"

static float deg;
static bool homed;
static bool powerOk;
static ValveDir moving = V_NONE;   // what the outputs are doing now
static ValveDir lastDir = V_NONE;  // last direction that actually ran (for backlash)
static bool parking;
static uint32_t moveEnd, lastIntegrate, stoppedAt;
static uint32_t backlashLeft;

static ValveDir pendDir = V_NONE;
static uint32_t pendMs;
static bool pendPark;

// The only writer of VO/VC: both LOW first, then at most one HIGH.
static void drive(ValveDir d) {
  digitalWrite(PIN_VO, LOW);
  digitalWrite(PIN_VC, LOW);
  if (d == V_OPEN) digitalWrite(PIN_VO, HIGH);
  else if (d == V_CLOSE) digitalWrite(PIN_VC, HIGH);
}

static void integrate(uint32_t now) {
  if (moving == V_NONE) return;
  uint32_t dt = now - lastIntegrate;
  lastIntegrate = now;
  if (backlashLeft) {
    uint32_t b = dt < backlashLeft ? dt : backlashLeft;
    backlashLeft -= b;
    dt -= b;
  }
  float full = moving == V_OPEN ? (float)V2_T_OPEN_MS : (float)V2_T_CLOSE_MS;
  deg += (moving == V_OPEN ? 90.0f : -90.0f) * dt / full;
  if (deg < 0) deg = 0;
  if (deg > 90) deg = 90;
}

// completed = the move ran its full time (only then does a park re-zero).
static void halt(uint32_t now, bool completed) {
  integrate(now);
  drive(V_NONE);
  if (moving != V_NONE) {
    lastDir = moving;
    stoppedAt = now;
  }
  moving = V_NONE;
  if (parking && completed) {
    deg = 0;
    homed = true;
  }
  parking = false;
}

static void begin(ValveDir d, uint32_t ms, bool park, uint32_t now) {
  backlashLeft = (lastDir != V_NONE && d != lastDir) ? V2_BACKLASH_MS : 0;
  moving = d;
  parking = park;
  lastIntegrate = now;
  moveEnd = now + ms;
  drive(d);
}

void valveInit() {
  drive(V_NONE);
  deg = 0;
  homed = false;
  stoppedAt = millis();
}

void valveSetPowerOk(bool ok) {
  if (powerOk && !ok) {
    halt(millis(), false);
    homed = false;          // position unknown until the next park
    pendDir = V_NONE;
    pendPark = false;
  }
  powerOk = ok;
}

void valveUpdate(uint32_t now) {
  if (moving != V_NONE) {
    if ((int32_t)(now - moveEnd) >= 0) halt(now, true);
    else integrate(now);
    return;
  }
  if (pendDir == V_NONE || !powerOk) return;
  // Dead time before reversing.
  if (lastDir != V_NONE && pendDir != lastDir && now - stoppedAt < V2_REVERSE_DEADTIME_MS) return;
  ValveDir d = pendDir;
  pendDir = V_NONE;
  begin(d, pendMs, pendPark, now);
}

static void request(ValveDir d, uint32_t ms, bool park) {
  pendDir = d;
  pendMs = ms;
  pendPark = park;
  valveUpdate(millis());
}

void valvePark() {
  if (!powerOk) return;
  if (parking || (pendPark && pendDir == V_CLOSE)) return;
  if (moving != V_NONE) halt(millis(), false);
  homed = false;
  request(V_CLOSE, V2_PARK_MS, true);
}

static const float EDGE_TOL_DEG = 0.5f;

bool valveStep(ValveDir dir, uint32_t ms) {
  if (!powerOk || !homed || valveBusy() || dir == V_NONE) return false;
  if (ms < V2_MIN_PULSE_MS) ms = V2_MIN_PULSE_MS;
  if (dir == V_CLOSE) {
    if (deg <= V2_FLOW_DEG + EDGE_TOL_DEG) return false;          // already shut to outdoor
    float toEdge = (deg - V2_FLOW_DEG) / 90.0f * V2_T_CLOSE_MS;   // stop at the edge, not in the dead zone
    if (ms > toEdge) ms = (uint32_t)toEdge;
    if (ms < V2_MIN_PULSE_MS) ms = V2_MIN_PULSE_MS;
  } else {
    if (deg >= 90.0f) return false;
    if (deg < V2_FLOW_DEG) ms += (uint32_t)((V2_FLOW_DEG - deg) / 90.0f * V2_T_OPEN_MS);  // cross the dead zone
  }
  request(dir, ms, false);
  return true;
}

void valveStop() {
  bool wasParking = parking || pendPark;
  halt(millis(), false);
  if (wasParking) homed = false;
  pendDir = V_NONE;
  pendPark = false;
}

bool valveBusy() { return moving != V_NONE || pendDir != V_NONE; }
bool valveHomed() { return homed; }
bool valveParked() { return homed && deg <= 0.0f && !valveBusy(); }
bool valveShut() { return homed && deg <= V2_FLOW_DEG + EDGE_TOL_DEG && !valveBusy(); }
float valveDeg() { return deg; }
ValveDir valveMoving() { return moving; }

bool valveJog(ValveDir dir, uint32_t ms) {
  if (!powerOk || valveBusy() || dir == V_NONE) return false;
  request(dir, ms, false);
  return true;
}

// Position helpers for the log (from the bench calibration, docs/changes/v2_calibration.md).
float valveOpenMm() {
  float ms = (deg - V2_FLOW_DEG) / 90.0f * V2_T_OPEN_MS;   // motion past the edge
  return ms > 0 ? ms * V2_MM_PER_MS : 0.0f;
}

float valveOutdoorPct() {
  float ms = deg / 90.0f * V2_T_OPEN_MS;                   // motion from bypass
  if (ms <= V2_DEAD_MS) return 0.0f;
  if (ms <= V2_HALF_MS) return 50.0f * (ms - V2_DEAD_MS) / (V2_HALF_MS - V2_DEAD_MS);
  float p = 50.0f + 50.0f * (ms - V2_HALF_MS) / (V2_T_OPEN_MS - V2_HALF_MS);
  return p > 100.0f ? 100.0f : p;
}

static float degForMs(float ms) { return ms / V2_T_OPEN_MS * 90.0f; }   // motion from bypass -> θ

float valveDegForMm(float mm) {
  if (mm < 0) mm = 0;
  return degForMs(V2_DEAD_MS + mm / V2_MM_PER_MS);
}

float valveDegForPct(float pct) {
  if (pct <= 0) return V2_FLOW_DEG;
  if (pct <= 50) return degForMs(V2_DEAD_MS + pct / 50.0f * (V2_HALF_MS - V2_DEAD_MS));
  if (pct > 100) pct = 100;
  return degForMs(V2_HALF_MS + (pct - 50) / 50.0f * (V2_T_OPEN_MS - V2_HALF_MS));
}

bool valveGoto(float target) {
  if (!powerOk || !homed || valveBusy()) return false;
  if (target < 0) target = 0;
  if (target > 90) target = 90;
  float diff = target - deg;
  if (diff > -0.3f && diff < 0.3f) return true;                 // already there
  ValveDir d = diff > 0 ? V_OPEN : V_CLOSE;
  float full = d == V_OPEN ? (float)V2_T_OPEN_MS : (float)V2_T_CLOSE_MS;
  uint32_t ms = (uint32_t)((diff > 0 ? diff : -diff) / 90.0f * full);
  if (lastDir != V_NONE && d != lastDir) ms += V2_BACKLASH_MS;   // begin() spends the play first
  request(d, ms, false);
  return true;
}
