darkmass2156/PCS/firmware/controller/sensors.h

#pragma once
#include <Arduino.h>

enum { SHT_A = 0, SHT_B = 1, SHT_R = 2, SHT_COUNT = 3 };

struct NtcReading {
  float c;          // NAN when the ADC reads a short or open
  float adc;        // filtered ADC counts (raw while open / shorted), for '?' diagnostics
  bool floating;    // the Mega pin isn't connected to the NTC node (broken ribbon / housing): invalid
  bool inRange;     // -40..80 right now
  bool valid;       // in range, or out of range for less than NTC_FAULT_MS
};

struct ShtReading {
  float t, rh, dp;
  bool valid;       // false until SHT_GOOD_LIMIT good reads; false after SHT_FAIL_LIMIT bad ones
  uint8_t fails, goods;
  uint16_t errCount;
};

extern NtcReading ntcT1, ntcT2, ntcT3;
extern ShtReading sht[SHT_COUNT];
extern uint16_t i2cRecoveries;   // Wire bus recoveries after a timeout (shown by '?')

void sensorsInit();
void sensorsUpdate(uint32_t now);   // non-blocking, call every loop pass
void sensorsRoomDiag();             // '?' only: SHT30 bus levels + 0x44/0x45 probe, pins as wired and swapped

// Max of the valid dew points; returns NAN and count 0 if none.
float dewPointMax(uint8_t &validCount, float &spread);
float dewPointMagnus(float t, float rh);

// Serial SIM overrides (bench): idx 0..2 = T1..T3 (replaces the NTC value), 3 = T_room (needs a valid SHT30; its DP
// stays real). NAN clears. The control logic and all faults see the overridden value.
void sensorsSetOverride(uint8_t idx, float v);
float sensorsOverride(uint8_t idx);
bool sensorsOverrideActive();
