darkmass2156/PCS/(commit log)

2026-10-17 Baseline: logic rev 1 spec, BOM rev 4b, schematic rev10
    Imported as received, before logic rev 2. Schematic re-encoded to PNG
    from the uploaded image.
    Claude-Session: https://claude.ai/code/session_01HnEjGPQNSCKLeo6WJ1MVhE
    [build_component_list_rev4b.xlsx]
2026-10-17 Logic rev 2: three setpoint modes, feasibility guard, T1 + SHT30
    Rewrite CLAUDE.md for control logic rev 2 (change note in
    docs/changes/logic_rev2.md), add schematic rev11, and start revision
    tracking with CHANGELOG.md. Spec gaps filled with ASSUMED items that
    are listed for confirmation.
    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
2026-10-17 FW 0.2.0, bench 1.1: LED heartbeat scheme, trimpot build, V2 calibration, UI dev
    - LED: Mode 1 white / 2 blue / 3 red slow breathing, 3 green pulses on
    mode change, driven from loop() so a hang freezes it before the WDT reset
    - NTC_TRIMPOT_SIM build with optional forced 12V and fake P2 tach
    - Display geometry in layout.h, generated by tests/11_ui_dev
    - All bench tests driven by BTN1/BTN2 via shared tests/common/bench.h
    - New tests/10_v2_calibration and tests/11_ui_dev
    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
    [00_watchdog.ino, 01_ntc.ino, 02_sht31_dewpoint.ino, 03_fuse_sense.ino, 04_buttons_led.ino, 05_fan_pwm_tach.ino, 06_display.ino, 07_valve.ino]
2026-10-17 FW 0.3.1, display rev 2: fix hobo splash selection and beak-patch artifacts
    - Splash choice in EEPROM (boot counter seed + last shown); the .noinit
    copy excluded penguin 0 on every cold start
    - Splash sprites and beak patches stream through one address window per
    chunk instead of one fillRect per colour run
    - Adopt the MADCTL mirror change behind DISP_TARGET_ILI9341_SIM so the
    simulator compensations can't reach the real ST7789
    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
    [11_ui_dev.ino, config.h, controller.ino, display.cpp, splash.h, version.h]
2026-10-17 FW 0.4.0, display rev 3: per-mode dashboards, glitch transition, ROG splash
    - Mode 1 standard, Mode 2 sport (graphite), Mode 3 engineer (P&ID, raw
    table, 272 s sweeping chart) in the ROG palette; widgets redraw only on
    change, segment digits per changed segment
    - Boot: Pingu noot -> glitch (torn bands, scanline noise, invert flashes,
    signal lost) -> ROG logo wipe -> dashboard
    - Case values = highest SHT31 per value; dew distance = T2 - DP max;
    K_POT 25 W/C placeholder; clock removed, 1 Hz dot kept
    - tools/ui_preview renders the real display code on the host
    - 11_ui_dev runs the real screens with fake data (bench 1.2)
    Claude-Ses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
    [11_ui_dev.ino, bench.h, config.h, display.cpp]
2026-10-17 FW 0.4.1, display rev 4: AA fonts in Mode 1, overlapping glitch into ROG
    - Mode 1 drawn with anti-aliased proportional fonts (FreeSans Bold big
    temperatures, DejaVu Sans values/labels) via ftxt(), streamed per field
    - Boot glitch: penguin tearing out and ROG logo bands glitching in now
    overlap; logo resolves in white, then a red scan
    - Fix: red scan restore slice could exceed the logo width
    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
    [scr_gfx.cpp, scr_gfx.h, splash.h, version.h]
2026-10-17 FW 0.4.2, display rev 5: fast crash into ROG, AA fonts in Modes 2/3, ui_dev shows all penguins
    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
    [11_ui_dev.ino, splash.h, version.h]
2026-10-17 FW 0.4.3, display rev 6: fix clipped Mode 2 digits, ui_dev plays one boot sequence
    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
    [11_ui_dev.ino, version.h]
2026-10-17 11_ui_dev: random startup penguin seeded from ADC noise, like the firmware
    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
    [11_ui_dev.ino]
2026-10-17 FW 0.4.4: ui_dev redraws the UI after a boot replay, splash restart resets scroll/invert
    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
    [11_ui_dev.ino, splash.h, version.h]
2026-10-26 12_disp170_sht31: RES on D48, boot colour flash, SPI mode toggle
    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
2026-10-26 12_disp170_sht31: split I2C error counters, sensor reset + heater off, status register, scan, sequential reads
    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
    [12_disp170_sht31.ino]
2026-10-26 12_disp170_sht31: single-sensor mode (default) with address switch, raw ticks, status register
    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
2026-10-27 FW 0.4.5: display SPI 4 MHz, 330/660 dividers for the 1.5 m cable
    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
2026-10-27 lite170 1.0: 1.9in case display with SHT31 A/B, boot sequence and 320x170 mode screens; FW 0.4.6 splash height-generic
    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
2026-10-28 SHT RH calibration: A +0.75 %, B -0.75 % in firmware 0.4.7, lite170 1.1 and the SHT sketches
    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
2026-10-28 SHT RH calibration A +1.15 %, B -1.15 %: FW 0.4.9, lite170 1.3, bench 1.6
    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
2026-11-01 FW 0.5.0, HW rev 6b: 1.9in screens in the controller, RES D47, I2C recovery, event log, bench SIM switches, LED scheme 2 option, 13_led_pins
    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
2026-11-01 FW 0.5.1: '?' prints NTC ADC counts, resistance and temperature
    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
2026-11-01 FW 0.5.2: NTC open-pin check (floating Mega pin reads as open), also in 01_ntc
    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
2026-11-01 FW 0.5.3: '?' probes the room SHT30 bus (levels, 0x44/0x45, swapped pins)
    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
    [controller.ino, sensors.cpp, sensors.h, version.h]
2026-11-01 Bench: 14_led_colors (LED colour map, mixer, white balance on the buttons)
    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
2026-11-01 FW 0.5.4 / lite 1.5: remove the 2 s alarm flash on the status LED
    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
2026-11-02 Bench: FUSE_CHECK switch in 07_valve / 10_v2_calibration (default off)
    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
2026-11-02 FW 0.6.0: V2 calibrated (5050 ms travel, 725 ms play, 1300 ms dead zone, 10 s park)
    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
2026-11-03 FW 0.7.0: serial test mode, fan alarm banner (disp 8), LED G/B as built + 80 %
    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
2026-11-03 FW 0.8.1 / lite 1.7: SHT T + RH calibrated to the median of the three
    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
2026-11-03 Bench: 10 min averaged SHT calibration run in 02_sht31_dewpoint
    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
2026-11-03 Bench: 05_fan_pwm_tach shows raw vs filtered tach
    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
2026-11-03 FW 0.8.2: fan tach inputs with internal pull-ups (wired straight PW -> Mega)
    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
2026-11-03 FW 0.8.3: tach edge filter (LOW check + 3 ms lockout) in all tach ISRs
    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
2026-11-03 FW 0.8.4: tach filter requires 1 ms HIGH before a counted edge
    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
2026-11-03 FW 0.9.0: one fan header (FAN2 + splitter), FAN1 tach dropped
    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
2026-11-03 hw.cpp: no unused FAN1 tach state when not fitted
    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
    [hw.cpp]
2026-11-03 Bench: 05_fan_pwm_tach prints per-pulse speed range
    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
2026-11-03 FW 0.9.1: tach sampled by Timer4 with debounce (no edge interrupts)
    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
2026-11-03 05_fan_pwm_tach: debounce helpers in tach_deb.h (IDE prototype generator broke the .ino)
    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
    [05_fan_pwm_tach.ino]
2026-11-04 Bench: 15_cal_all calibrates NTCs and SHTs to one another in one run
    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
2026-11-04 FW 0.9.3: serial SIM overrides + mode, reset counters, flash-free display self-heal, 1.9in only
    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
    [11_ui_dev.ino, config.h, control.cpp, control.h, controller.ino, display.cpp, screens170.cpp, screens170.h]
2026-11-05 FW 0.9.4: FAN_PWM_MIN 30 and fan kick-start from standstill
    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
2026-11-05 FW 0.9.5: fan 1 tach back, reports fan 2 below 30 %; 05 line-based serial
    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
2026-11-06 FW 0.9.7a: passive LG rebuild - buttons INPUT_PULLUP, fuse sense averaged, D34/D36 pulled up
    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
2026-11-06 FW 0.9.7b: fan 1 tach off (FAN1_TACH_FITTED 0), D18 unused
    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
2026-11-06 FW 0.9.7c: fan minimum 10 %, 30 % boosts on start / stall / hourly exercise, fan tuning block
    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
    [config.h, control.cpp, version.h]
2026-11-06 FW 0.9.7d: fix t-prefix commands entering test mode, Tout SIM override, Ret/Mix/Rad names
    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
    [control.cpp, control.h, controller.ino, version.h]
2026-11-06 FW 0.9.7e: display SPI 1 MHz (PC install: artifacts at 2, crash at 4)
    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
    [config.h, display.cpp, version.h]
2026-11-06 Docs: ESP32 display driver noted as PROPOSAL (display corrupts at 1 MHz in the PC)
    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
2026-11-06 tools: pcs_term.py, PC serial terminal with DTR off (no reset on connect)
    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
    [pcs_term.py]
